arfanbabaucoder/Herox/Images/Screenshot 2026-10-18 102629.png

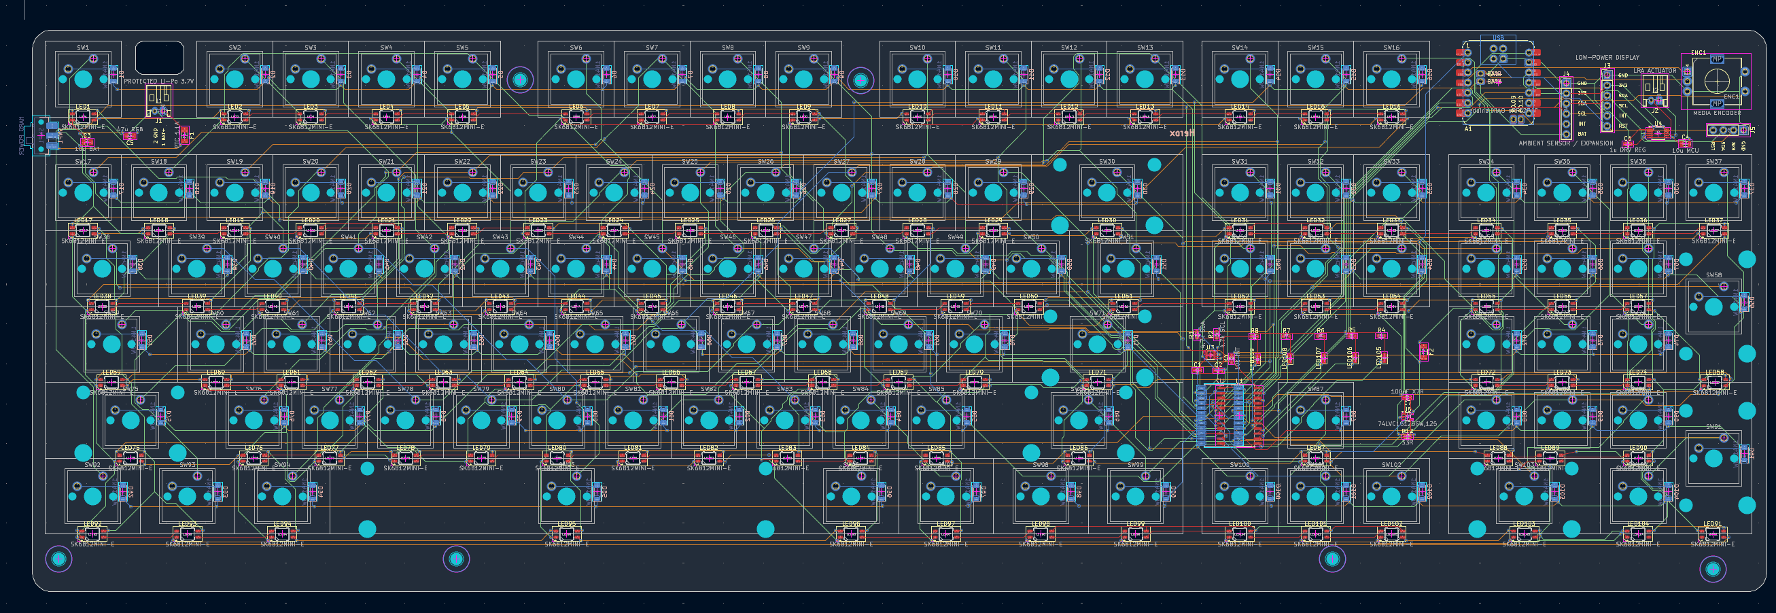
Images/Screenshot 2026-10-18 102629.png
