arfanbabaucoder/Herox/Production/bom.csv

Designator | Footprint | Quantity | Value | LCSC Part #
A1 | Xiao_nRF52840_ACH | 1 | Seeeduino XIAO nRF52840
C1 | 0603 | 1 | 100n U1
C2 | 0603 | 1 | 100n U2
C3 | 0805 | 1 | 10u BAT
C4 | 0805 | 1 | 10u MCU
C5 | 0805 | 1 | 47u RGB
C6 | 0603 | 1 | 1u DRV REG
C7 | 0603 | 1 | 100nF X7R
D1, D10, D100, D101, D102, D103, D104, D11, D12, D13, D14, D15, D16, D17, D18, D19, D2, D20, D21, D22, D23, D24, D25, D26, D27, D28, D29, D3, D30, D31, D32, D33, D34, D35, D36, D37, D38, D39, D4, D40, D41, D42, D43, D44, D45, D46, D47, D48, D49, D5, D50, D51, D52, D53, D54, D55, D56, D57, D58, D59, D6, D60, D61, D62, D63, D64, D65, D66, D67, D68, D69, D7, D70, D71, D72, D73, D74, D75, D76, D77, D78, D79, D8, D80, D81, D82, D83, D84, D85, D86, D87, D88, D89, D9, D90, D91, D92, D93, D94, D95, D96, D97, D98, D99 | D_SOD-123 | 104 | 1N4148W
ENC1 | RotaryEncoder_Alps_EC11E-Switch_Vertical_H20mm | 1 | MEDIA ENCODER
F1 | 1206 | 1 | PTC 1.1A
F2 | 1206 | 1 | PTC 0.5A / USB RGB
J1 | JST_PH_S2B-PH-K_1x02_P2.00mm_Horizontal | 1 | PROTECTED Li-Po 3.7V
J2 | JST_PH_S2B-PH-K_1x02_P2.00mm_Horizontal | 1 | LRA ACTUATOR
J3 | PinHeader_1x06_P2.54mm_Vertical | 1 | LOW-POWER DISPLAY
J4 | PinHeader_1x06_P2.54mm_Vertical | 1 | AMBIENT SENSOR / EXPANSION
J5 | PinHeader_1x04_P2.54mm_Vertical | 1 | SWD DEBUG
LED1, LED10, LED100, LED101, LED102, LED103, LED104, LED11, LED12, LED13, LED14, LED15, LED16, LED17, LED18, LED19, LED2, LED20, LED21, LED22, LED23, LED24, LED25, LED26, LED27, LED28, LED29, LED3, LED30, LED31, LED32, LED33, LED34, LED35, LED36, LED37, LED38, LED39, LED4, LED40, LED41, LED42, LED43, LED44, LED45, LED46, LED47, LED48, LED49, LED5, LED50, LED51, LED52, LED53, LED54, LED55, LED56, LED57, LED58, LED59, LED6, LED60, LED61, LED62, LED63, LED64, LED65, LED66, LED67, LED68, LED69, LED7, LED70, LED71, LED72, LED73, LED74, LED75, LED76, LED77, LED78, LED79, LED8, LED80, LED81, LED82, LED83, LED84, LED85, LED86, LED87, LED88, LED89, LED9, LED90, LED91, LED92, LED93, LED94, LED95, LED96, LED97, LED98, LED99 | LED_SK6812MINI-E_3.2x2.8mm_P1.5mm_ReverseMount | 104 | SK6812MINI-E
LED105, LED106 | 0603 | 2 | XL-1608UGC-04 GREEN
LED107, LED108, LED109 | 0603 | 3 | LTST-C193TBKT-5A BLUE
R1 | 0603 | 1 | 4.7k SDA
R12 | 0603 | 1 | 33R
R2 | 0603 | 1 | 4.7k SCL
R3 | 0603 | 1 | 10k INT
R4, R5, R6, R7, R8 | 0603 | 5 | 1k STATUS
SW1 | SW_MX_1.00u | 1 | Esc
SW10 | SW_MX_1.00u | 1 | F9
SW100 | SW_MX_1.00u | 1 | Left
SW101 | SW_MX_1.00u | 1 | Down
SW102 | SW_MX_1.00u | 1 | Right
SW103 | SW_MX_2.00u | 1 | 0
SW104 | SW_MX_1.00u | 1 | .
SW11 | SW_MX_1.00u | 1 | F10
SW12 | SW_MX_1.00u | 1 | F11
SW13 | SW_MX_1.00u | 1 | F12
SW14 | SW_MX_1.00u | 1 | PrtSc
SW15 | SW_MX_1.00u | 1 | Scroll
SW16 | SW_MX_1.00u | 1 | Pause
SW17 | SW_MX_1.00u | 1 | `~
SW18 | SW_MX_1.00u | 1 | 1!
SW19 | SW_MX_1.00u | 1 | 2@
SW2 | SW_MX_1.00u | 1 | F1
SW20 | SW_MX_1.00u | 1 | 3#
SW21 | SW_MX_1.00u | 1 | 4$
SW22 | SW_MX_1.00u | 1 | 5%
SW23 | SW_MX_1.00u | 1 | 6^
SW24 | SW_MX_1.00u | 1 | 7&
SW25 | SW_MX_1.00u | 1 | 8*
SW26 | SW_MX_1.00u | 1 | 9(
SW27 | SW_MX_1.00u | 1 | 0)
SW28 | SW_MX_1.00u | 1 | -_
SW29 | SW_MX_1.00u | 1 | =+
SW3 | SW_MX_1.00u | 1 | F2
SW30 | SW_MX_2.00u | 1 | Backspace
SW31 | SW_MX_1.00u | 1 | Insert
SW32 | SW_MX_1.00u | 1 | Home
SW33 | SW_MX_1.00u | 1 | PgUp
SW34 | SW_MX_1.00u | 1 | Num
SW35 | SW_MX_1.00u | 1 | /
SW36 | SW_MX_1.00u | 1 | *
SW37 | SW_MX_1.00u | 1 | -
SW38 | SW_MX_1.50u | 1 | Tab
SW39 | SW_MX_1.00u | 1 | Q
SW4 | SW_MX_1.00u | 1 | F3
SW40 | SW_MX_1.00u | 1 | W
SW41 | SW_MX_1.00u | 1 | E
SW42 | SW_MX_1.00u | 1 | R
SW43 | SW_MX_1.00u | 1 | T
SW44 | SW_MX_1.00u | 1 | Y
SW45 | SW_MX_1.00u | 1 | U
SW46 | SW_MX_1.00u | 1 | I
SW47 | SW_MX_1.00u | 1 | O
SW48 | SW_MX_1.00u | 1 | P
SW49 | SW_MX_1.00u | 1 | [{
SW5 | SW_MX_1.00u | 1 | F4
SW50 | SW_MX_1.00u | 1 | ]}
SW51 | SW_MX_1.50u | 1 | \
SW52 | SW_MX_1.00u | 1 | Delete
SW53 | SW_MX_1.00u | 1 | End
SW54 | SW_MX_1.00u | 1 | PgDn
SW55 | SW_MX_1.00u | 1 | 7
SW56 | SW_MX_1.00u | 1 | 8
SW57 | SW_MX_1.00u | 1 | 9
SW58 | SW_MX_2.00u_Vertical | 1 | +
SW59 | SW_MX_1.75u | 1 | Caps
SW6 | SW_MX_1.00u | 1 | F5
SW60 | SW_MX_1.00u | 1 | A
SW61 | SW_MX_1.00u | 1 | S
SW62 | SW_MX_1.00u | 1 | D
SW63 | SW_MX_1.00u | 1 | F
SW64 | SW_MX_1.00u | 1 | G
SW65 | SW_MX_1.00u | 1 | H
SW66 | SW_MX_1.00u | 1 | J
SW67 | SW_MX_1.00u | 1 | K
SW68 | SW_MX_1.00u | 1 | L
SW69 | SW_MX_1.00u | 1 | ;:
SW7 | SW_MX_1.00u | 1 | F6
SW70 | SW_MX_1.00u | 1 | '"
SW71 | SW_MX_2.25u | 1 | Enter
SW72 | SW_MX_1.00u | 1 | 4
SW73 | SW_MX_1.00u | 1 | 5
SW74 | SW_MX_1.00u | 1 | 6
SW75 | SW_MX_2.25u | 1 | LShift
SW76 | SW_MX_1.00u | 1 | Z
SW77 | SW_MX_1.00u | 1 | X
SW78 | SW_MX_1.00u | 1 | C
SW79 | SW_MX_1.00u | 1 | V
SW8 | SW_MX_1.00u | 1 | F7
SW80 | SW_MX_1.00u | 1 | B
SW81 | SW_MX_1.00u | 1 | N
SW82 | SW_MX_1.00u | 1 | M
SW83 | SW_MX_1.00u | 1 | ,<
SW84 | SW_MX_1.00u | 1 | .>
SW85 | SW_MX_1.00u | 1 | /?
SW86 | SW_MX_2.75u | 1 | RShift
SW87 | SW_MX_1.00u | 1 | Up
SW88 | SW_MX_1.00u | 1 | 1
SW89 | SW_MX_1.00u | 1 | 2
SW9 | SW_MX_1.00u | 1 | F8
SW90 | SW_MX_1.00u | 1 | 3
SW91 | SW_MX_2.00u_Vertical | 1 | NEnter
SW92 | SW_MX_1.25u | 1 | LCtrl
SW93 | SW_MX_1.25u | 1 | LWin
SW94 | SW_MX_1.25u | 1 | LAlt
SW95 | SW_MX_6.25u | 1 | Space
SW96 | SW_MX_1.25u | 1 | RAlt
SW97 | SW_MX_1.25u | 1 | RWin
SW98 | SW_MX_1.25u | 1 | Menu
SW99 | SW_MX_1.25u | 1 | RCtrl
SWP1 | SW_SPDT_CK_JS102011SAQN | 1 | HARD POWER
U1 | SOIC-24W_7.5x15.4mm_P1.27mm | 1 | TCA9555DW / ROW DRIVE
U2 | SOIC-24W_7.5x15.4mm_P1.27mm | 1 | TCA9555DW / COLUMN SENSE
U3 | TDFN-8-1EP_2x2mm_P0.5mm_EP0.8x1.2mm | 1 | MAX17048G+T10 FUEL GAUGE
U4 | MSOP-10_3x3mm_P0.5mm | 1 | DRV2605L HAPTIC DRIVER
U5 | SOT-353_SC-70-5 | 1 | 74LVC1G125GW,125
