arfanbabaucoder/Herox/BOM Images/Screenshoot 2026-10-18 210038.jpeg

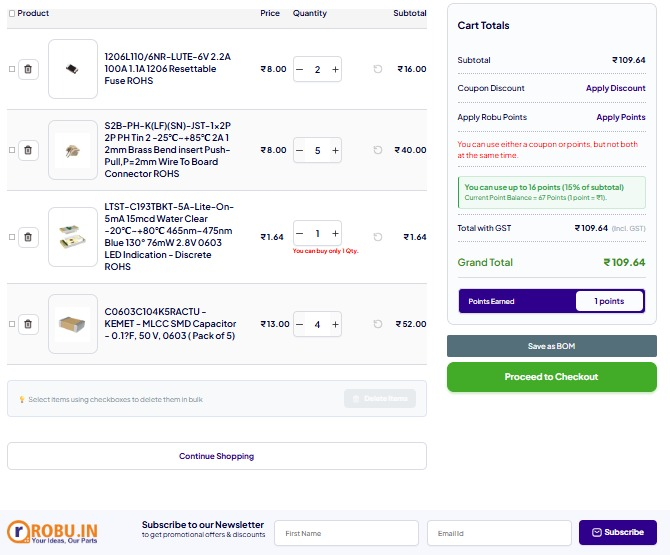
BOM Images/Screenshoot 2026-10-18 210038.jpeg
