arfanbabaucoder/Herox/BOM Images/Screenshot 2026-10-18 202717.png

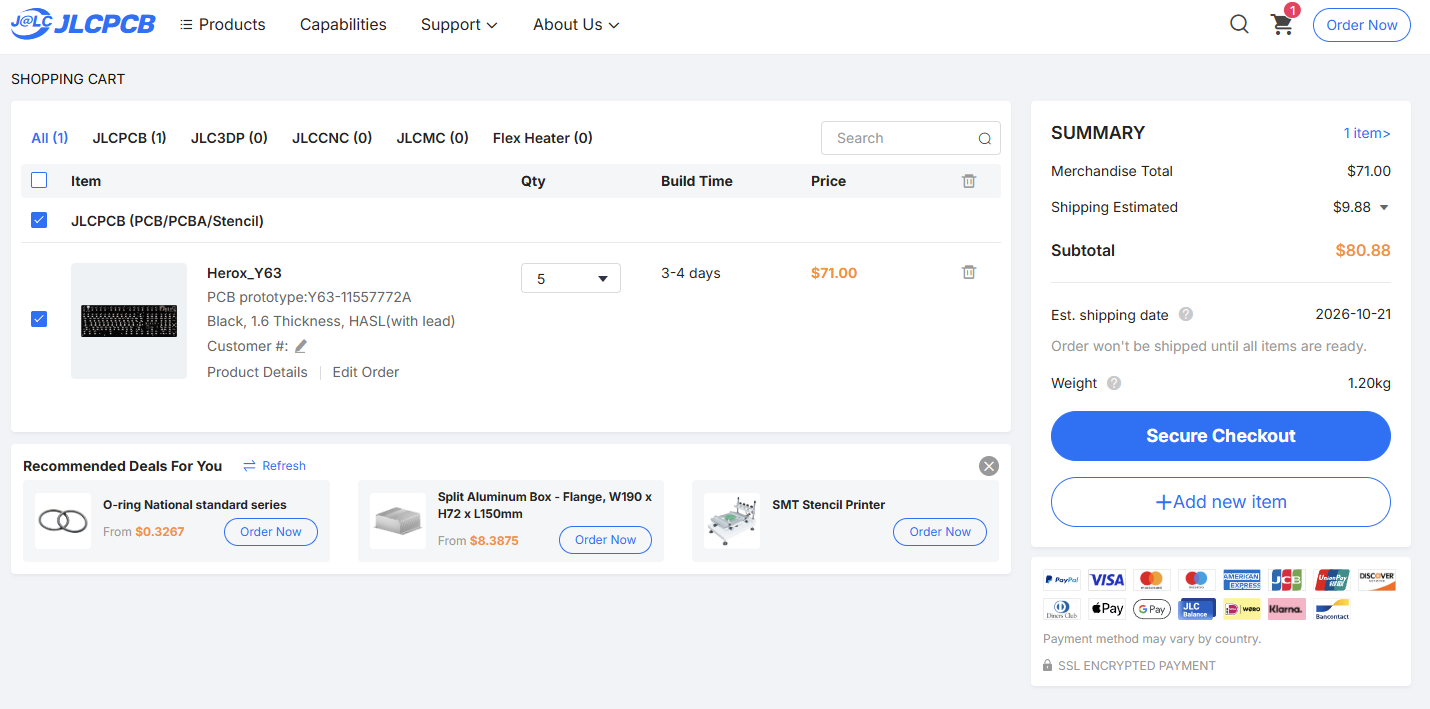
BOM Images/Screenshot 2026-10-18 202717.png
