arfanbabaucoder/Herox/BOM Images/Screenshot 2026-10-18 202721.png

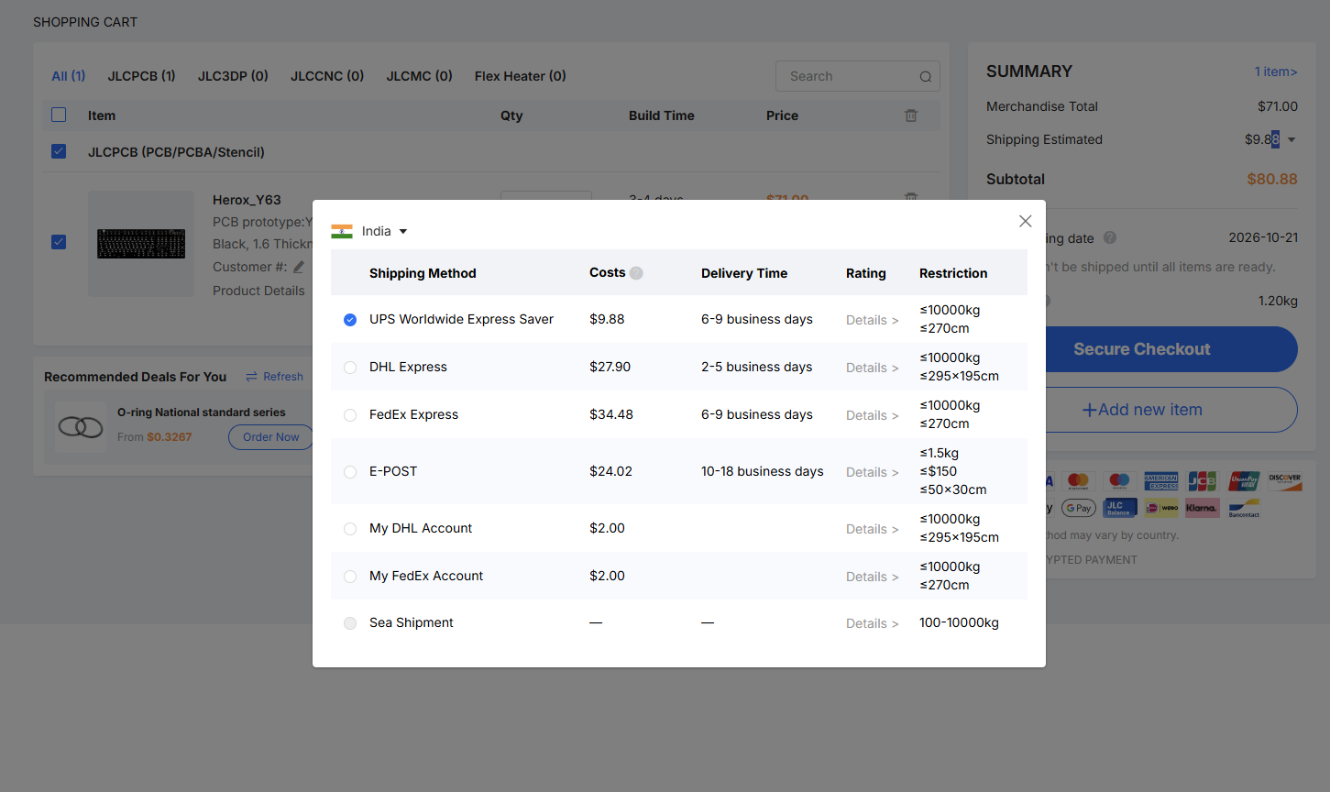
BOM Images/Screenshot 2026-10-18 202721.png
