arfanbabaucoder/Herox/BOM Images/Screenshot 2026-10-18 210037.png

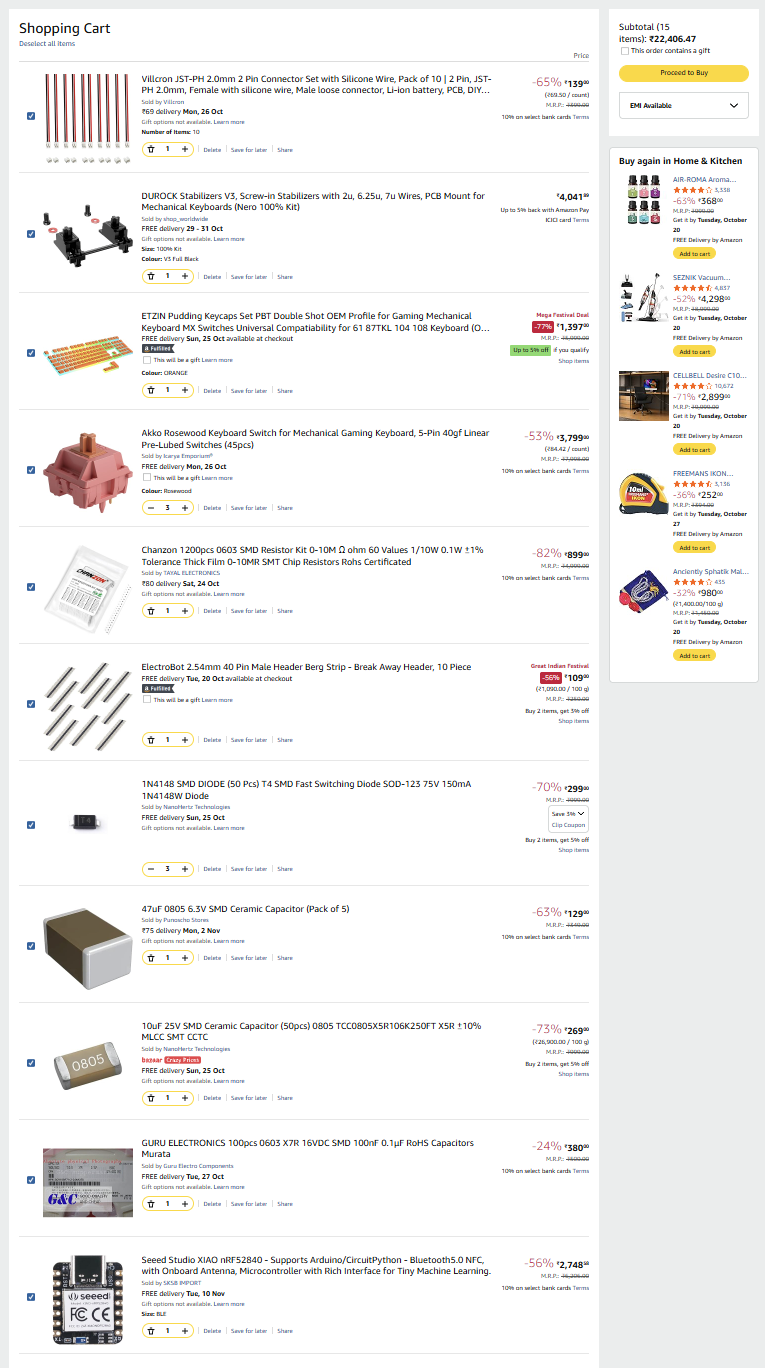
BOM Images/Screenshot 2026-10-18 210037.png
