arfanbabaucoder/Herox/3D CAD/Full/Herox.step

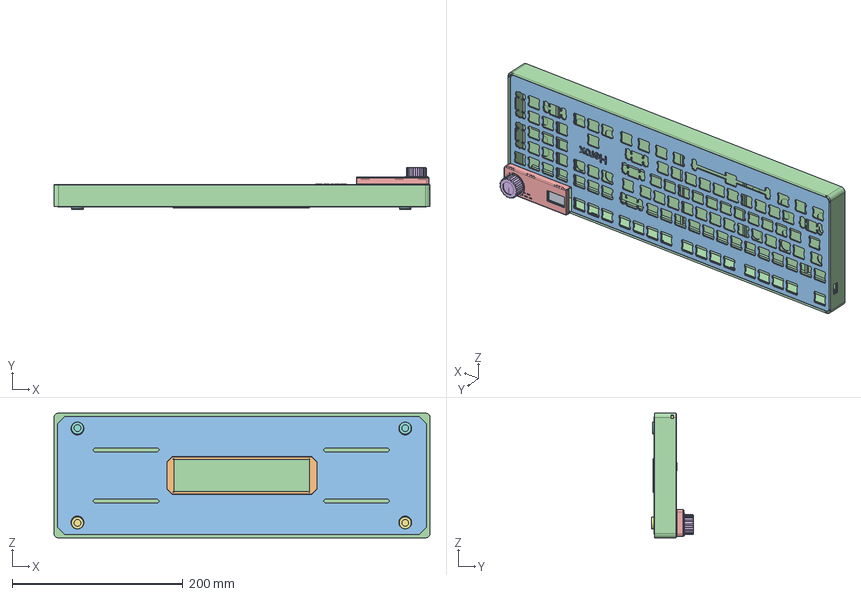
[picture p25: CAD file, 2026-10-18]
3D CAD/Full/Herox.step
440.5 x 48.9 x 146.0 mm
