arfanbabaucoder/Herox/3D CAD/Printables/Front_Right_Foot.stl

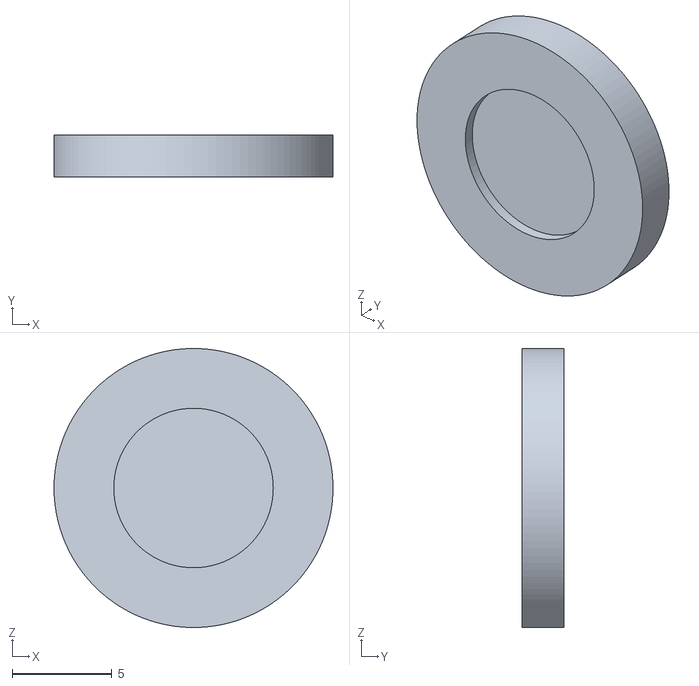
[picture p26: CAD file, 2026-10-18]
3D CAD/Printables/Front_Right_Foot.stl
14.0 x 2.10 x 14.0
