arfanbabaucoder/Herox/3D CAD/Printables/Plate_1.6mm.stl

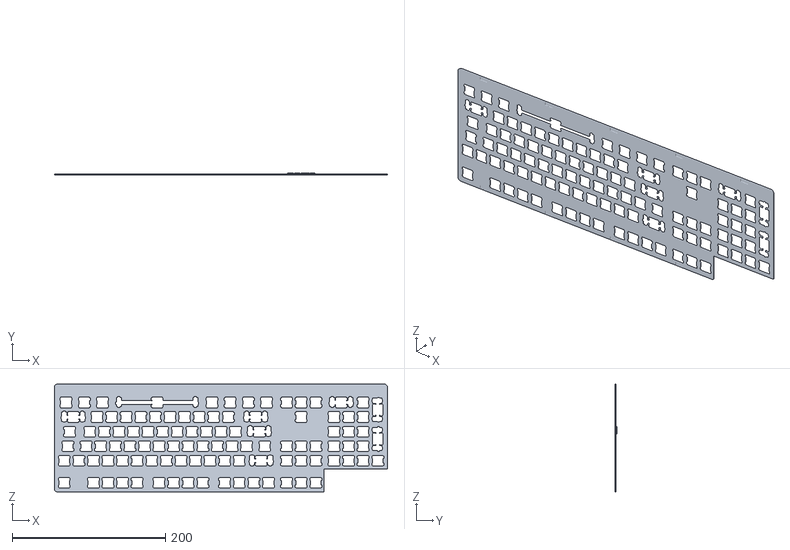
[picture p27: CAD file, 2026-10-18]
3D CAD/Printables/Plate_1.6mm.stl
435.0 x 2.60 x 141.0
