arfanbabaucoder/Herox/PCB/Plate.dxf

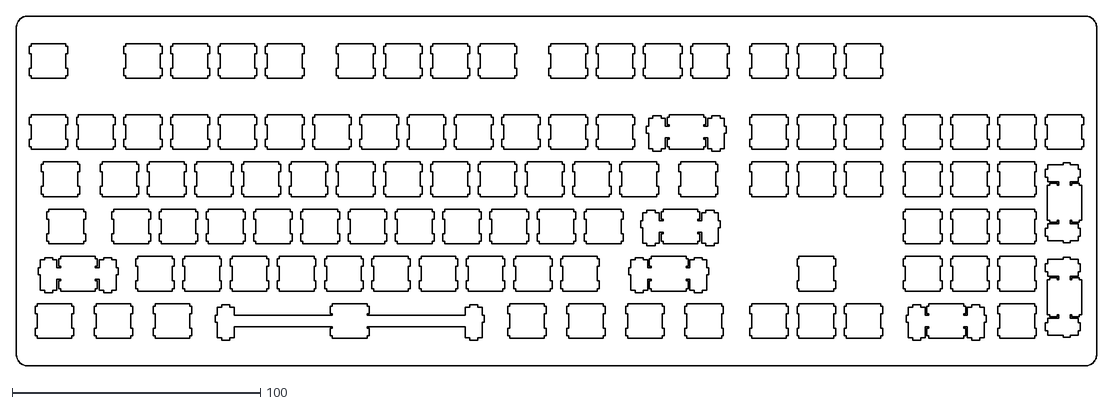
[picture p28: CAD file, 2026-10-18]
PCB/Plate.dxf
435.5 x 141.0
