arfanbabaucoder/Herox/3D CAD/Printables/Rear_Right_Foot.stl

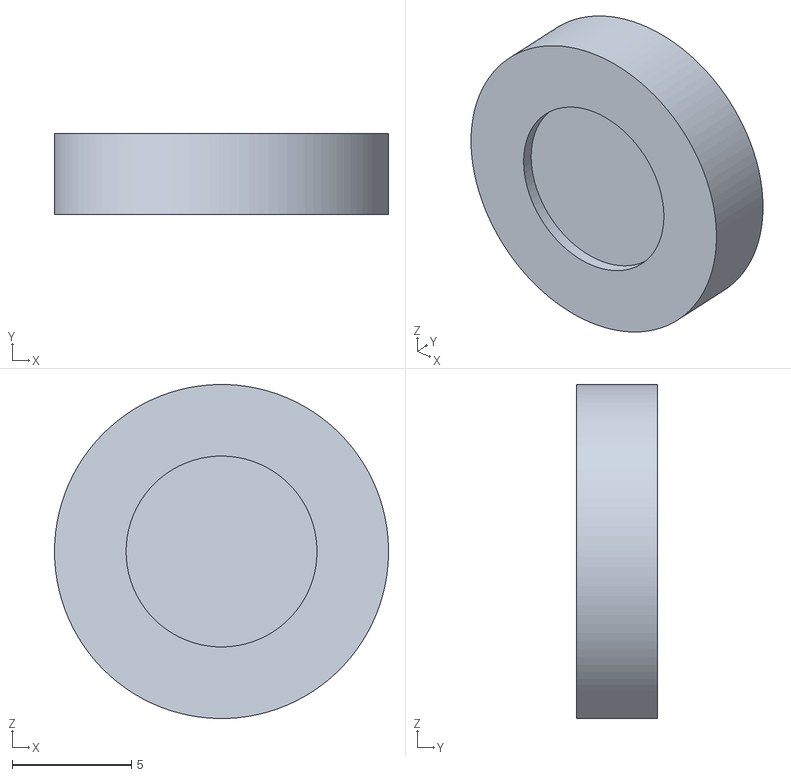
[picture p29: CAD file, 2026-10-18]
3D CAD/Printables/Rear_Right_Foot.stl
14.0 x 3.40 x 14.0
