arfanbabaucoder/Herox/3D CAD/Printables/Integrated_Control_Console.stl

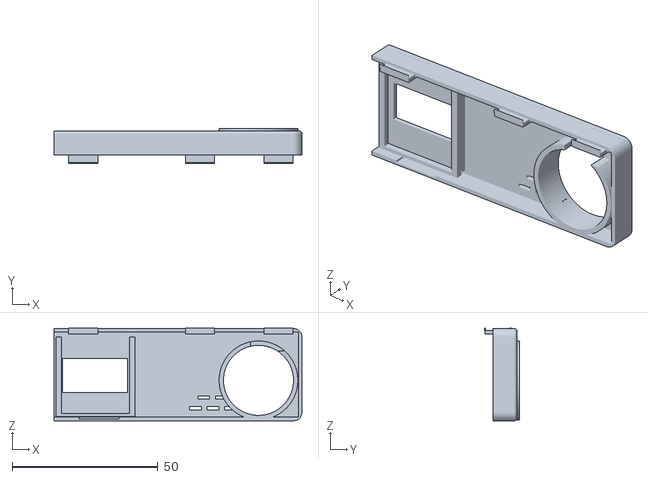
[picture p30: CAD file, 2026-10-18]
3D CAD/Printables/Integrated_Control_Console.stl
85.0 x 11.9 x 31.8
