arfanbabaucoder/Herox/3D CAD/Printables/Encoder_Knob_Cap.stl

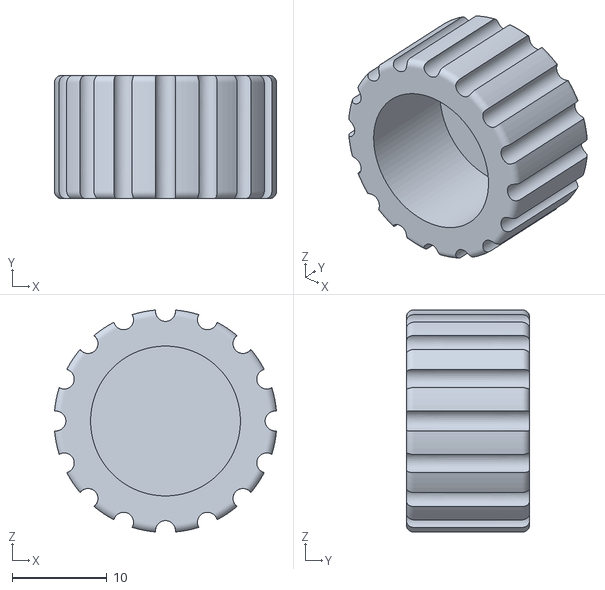
[picture p31: CAD file, 2026-10-18]
3D CAD/Printables/Encoder_Knob_Cap.stl
23.4 x 13.0 x 23.4
