arfanbabaucoder/Herox/3D CAD/Printables/BUTTON + INPUT RACK.stl

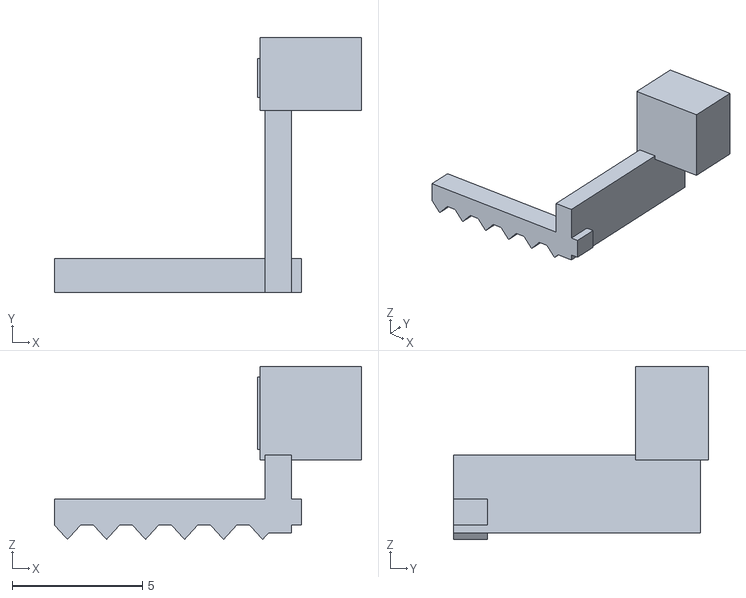
[picture p32: CAD file, 2026-10-18]
3D CAD/Printables/BUTTON + INPUT RACK.stl
11.8 x 9.80 x 6.65
