arfanbabaucoder/Herox/3D CAD/Printables/Bottom_Case_FDM_Print.stl

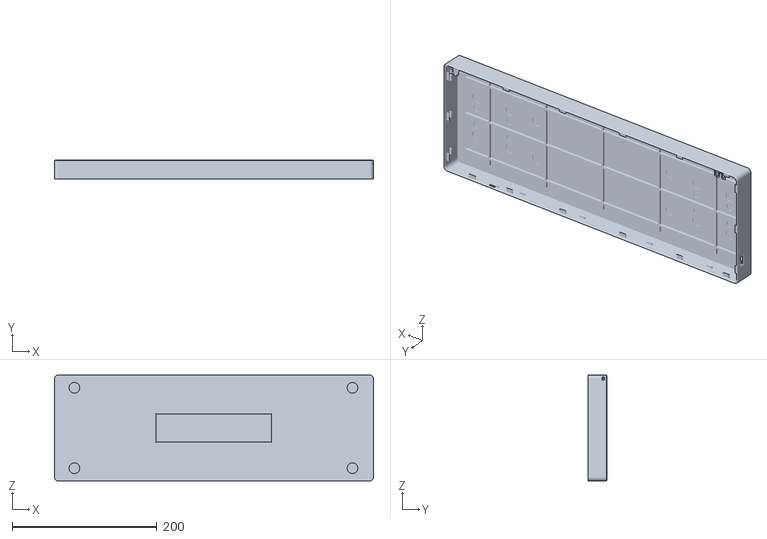
[picture p33: CAD file, 2026-10-18]
3D CAD/Printables/Bottom_Case_FDM_Print.stl
440.5 x 26.0 x 146.0
