arfanbabaucoder/Herox/3D CAD/Printables/Ballast_Press_Release_Key.stl

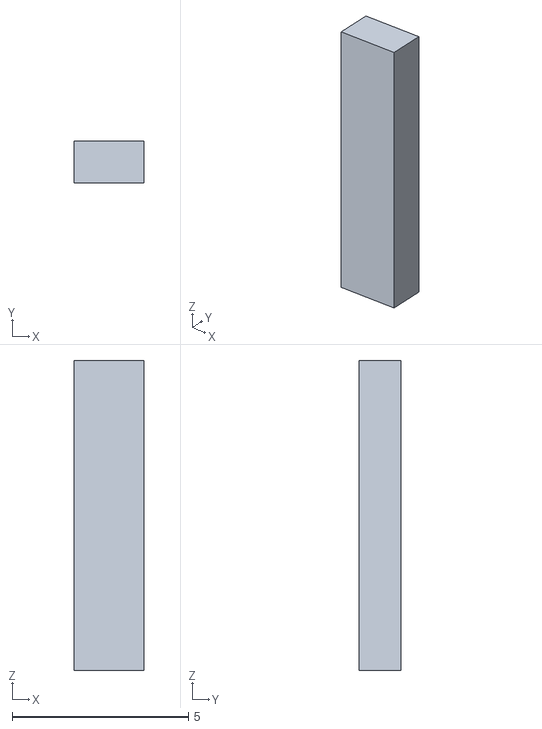
[picture p34: CAD file, 2026-10-18]
3D CAD/Printables/Ballast_Press_Release_Key.stl
2.00 x 1.20 x 8.80
