arfanbabaucoder/Herox/3D CAD/Printables/CARRIAGE - HIDDEN LATCH SLIDER.stl

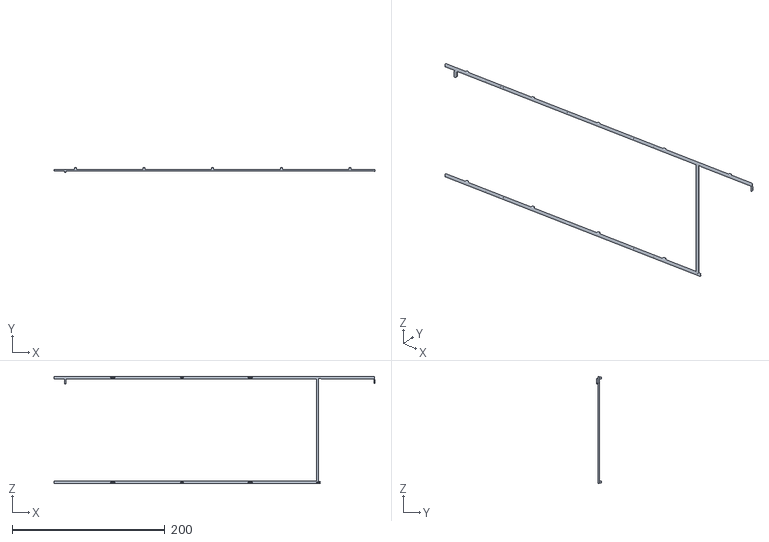
[picture p35: CAD file, 2026-10-18]
3D CAD/Printables/CARRIAGE - HIDDEN LATCH SLIDER.stl
420.8 x 6.05 x 140.4
