arfanbabaucoder/Herox/3D CAD/Printables/Gear.stl

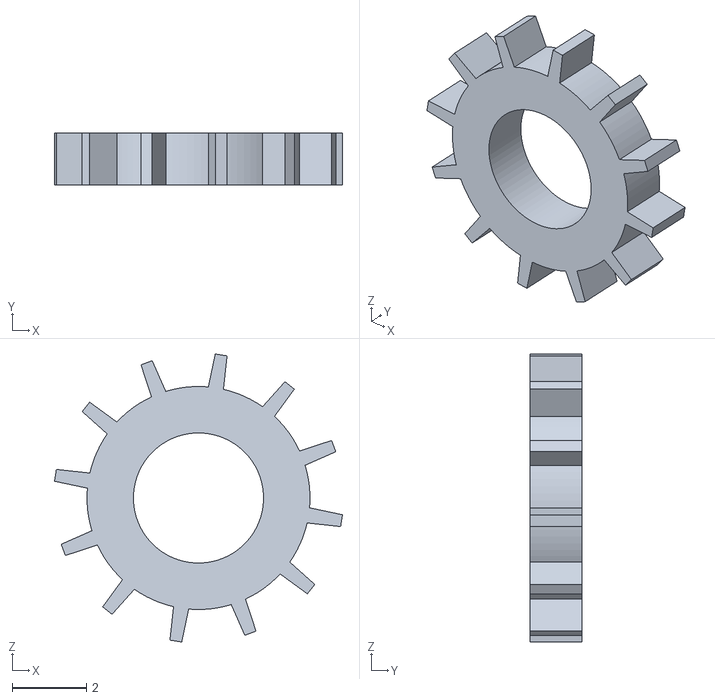
[picture p36: CAD file, 2026-10-18]
3D CAD/Printables/Gear.stl
7.75 x 1.40 x 7.75
