arfanbabaucoder/Herox/3D CAD/Printables/OUTPUT RACK SLIDER.stl

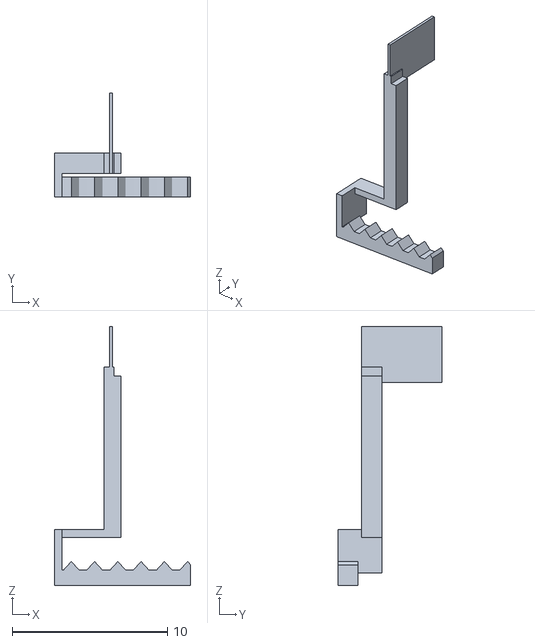
[picture p37: CAD file, 2026-10-18]
3D CAD/Printables/OUTPUT RACK SLIDER.stl
8.80 x 6.70 x 16.7
