arfanbabaucoder/Herox/3D CAD/Printables/Brass_Ballast_158x38x1.stl

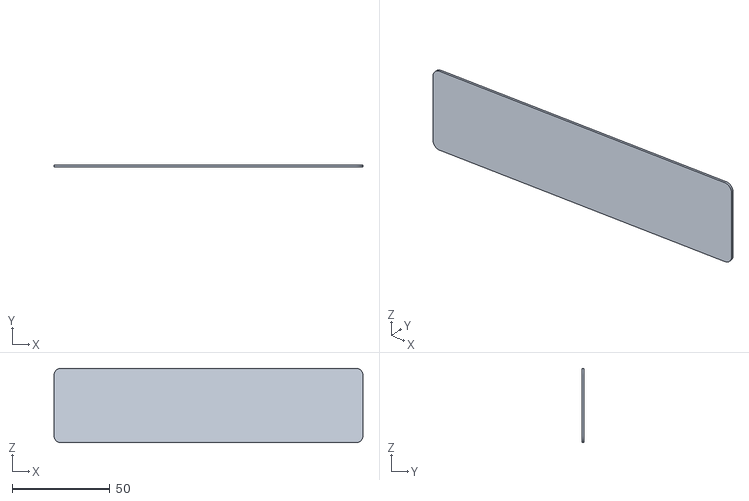
[picture p38: CAD file, 2026-10-18]
3D CAD/Printables/Brass_Ballast_158x38x1.stl
158.0 x 1.00 x 38.0
