arfanbabaucoder/Herox/PCB/JS102011SAQN.STEP

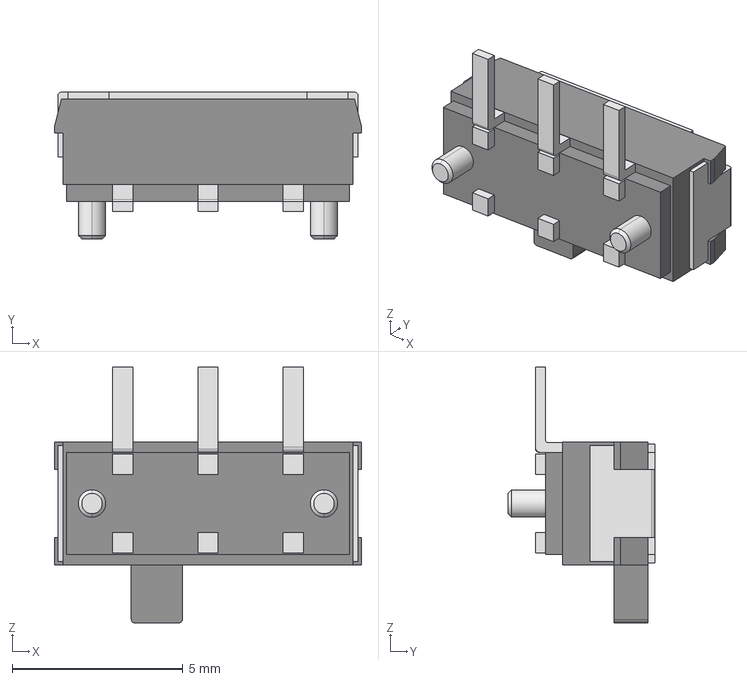
[picture p39: CAD file, 2026-10-18]
PCB/JS102011SAQN.STEP
9.00 x 4.30 x 7.50 mm
