arfanbabaucoder/Herox/(list of files, cad)

Other CAD files:
3D CAD/Printables/Rear_Left_Foot.stl
3D CAD/Printables/Front_Left_Foot.stl
