arfanbabaucoder/Herox/PDFs/Herox Schematic.pdf

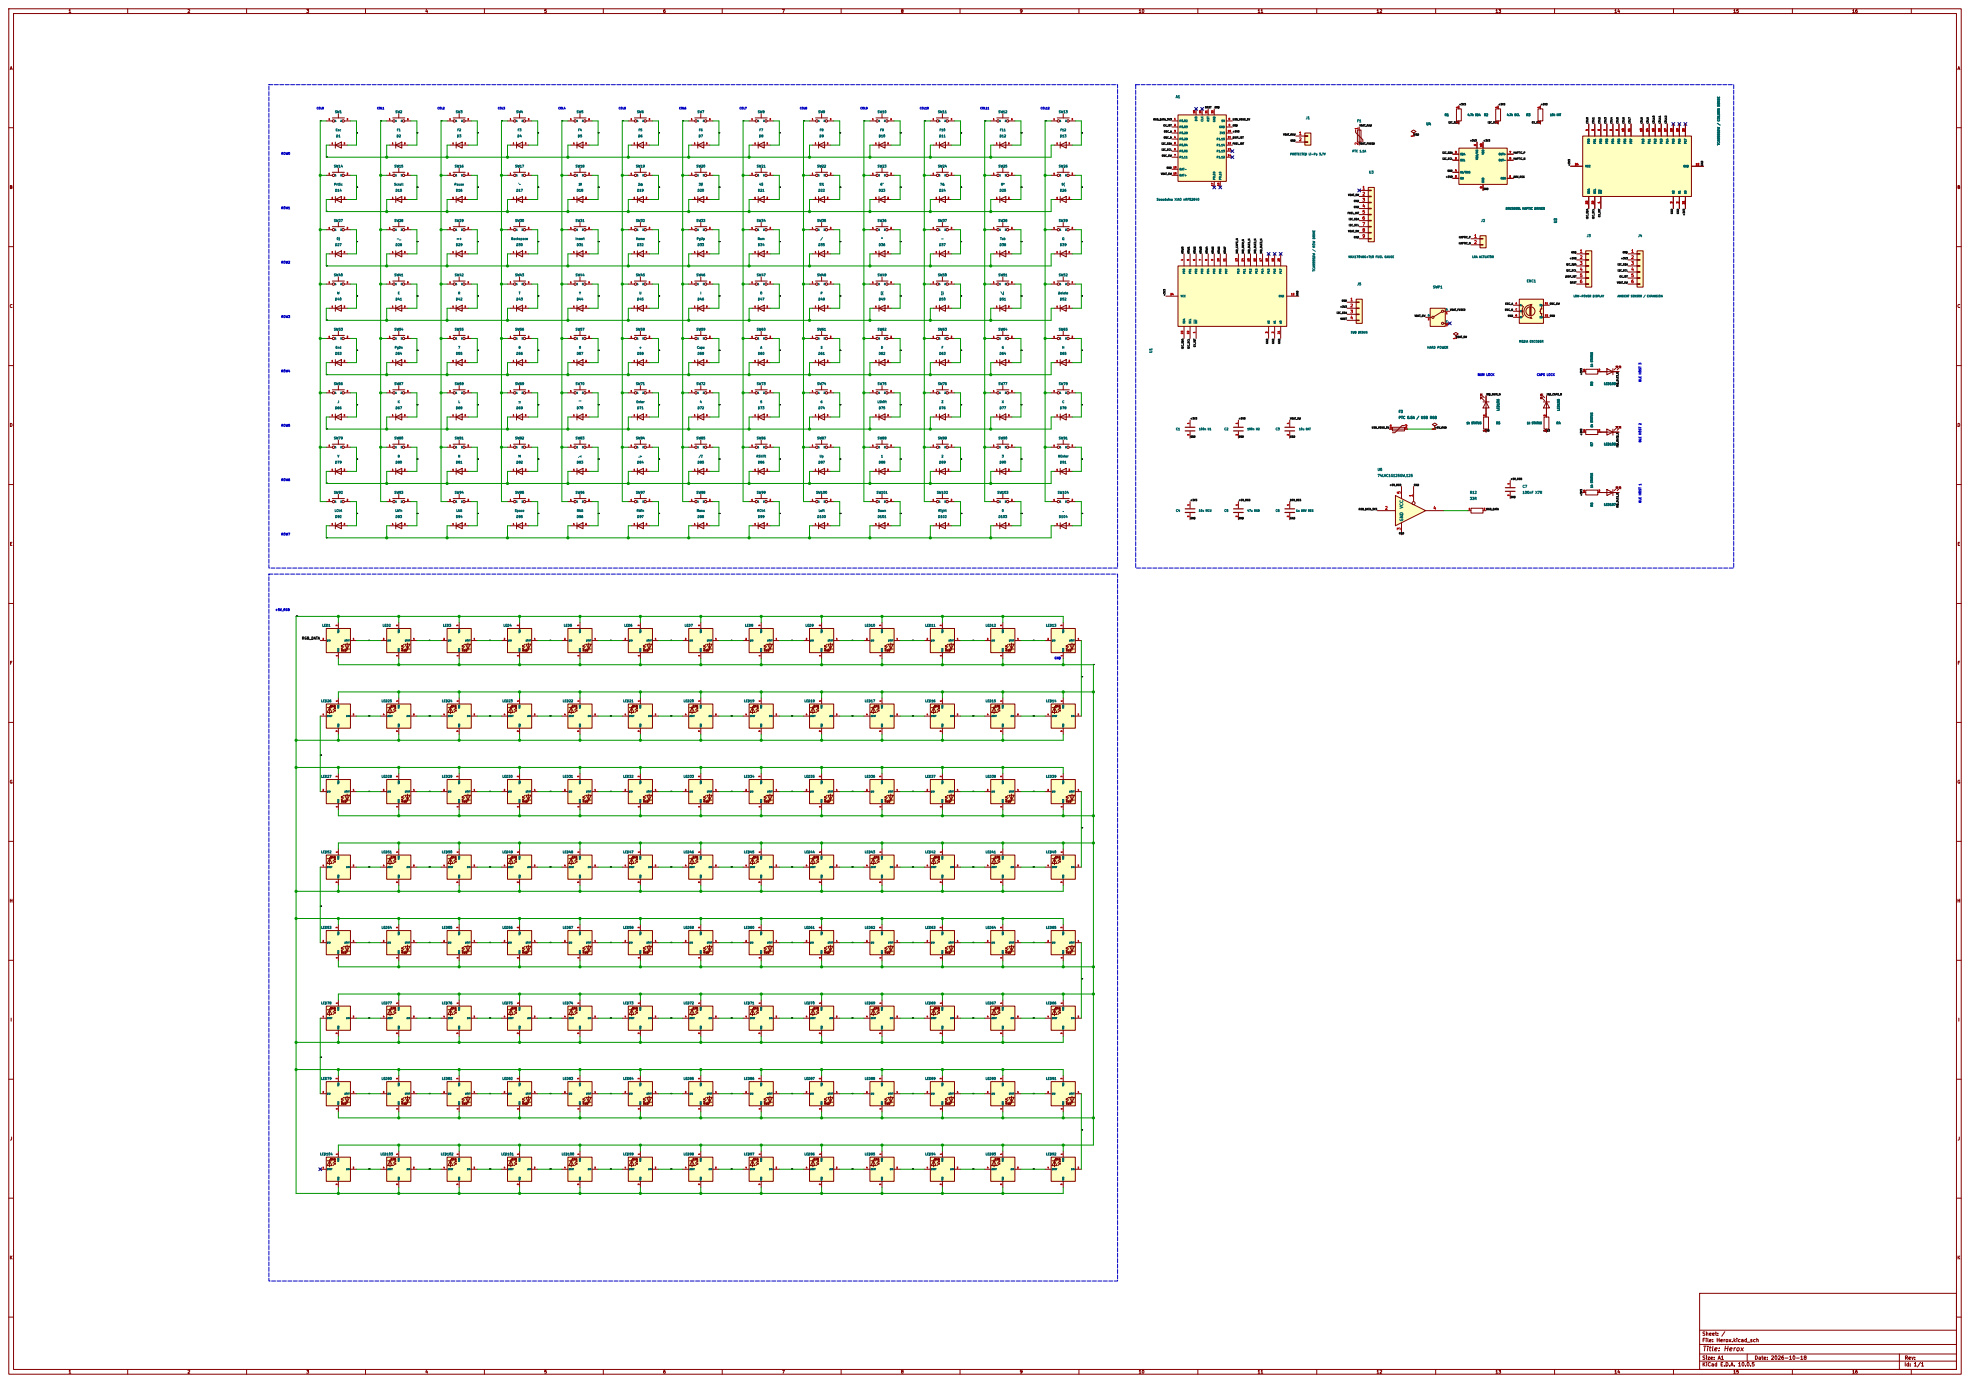
[picture p40: page 1]

Size: A1 | Rev:
KiCad E.D.A. 10.0.5 | Id: 1/1
