arfanbabaucoder/Herox/PDFs/Herox Layout.pdf

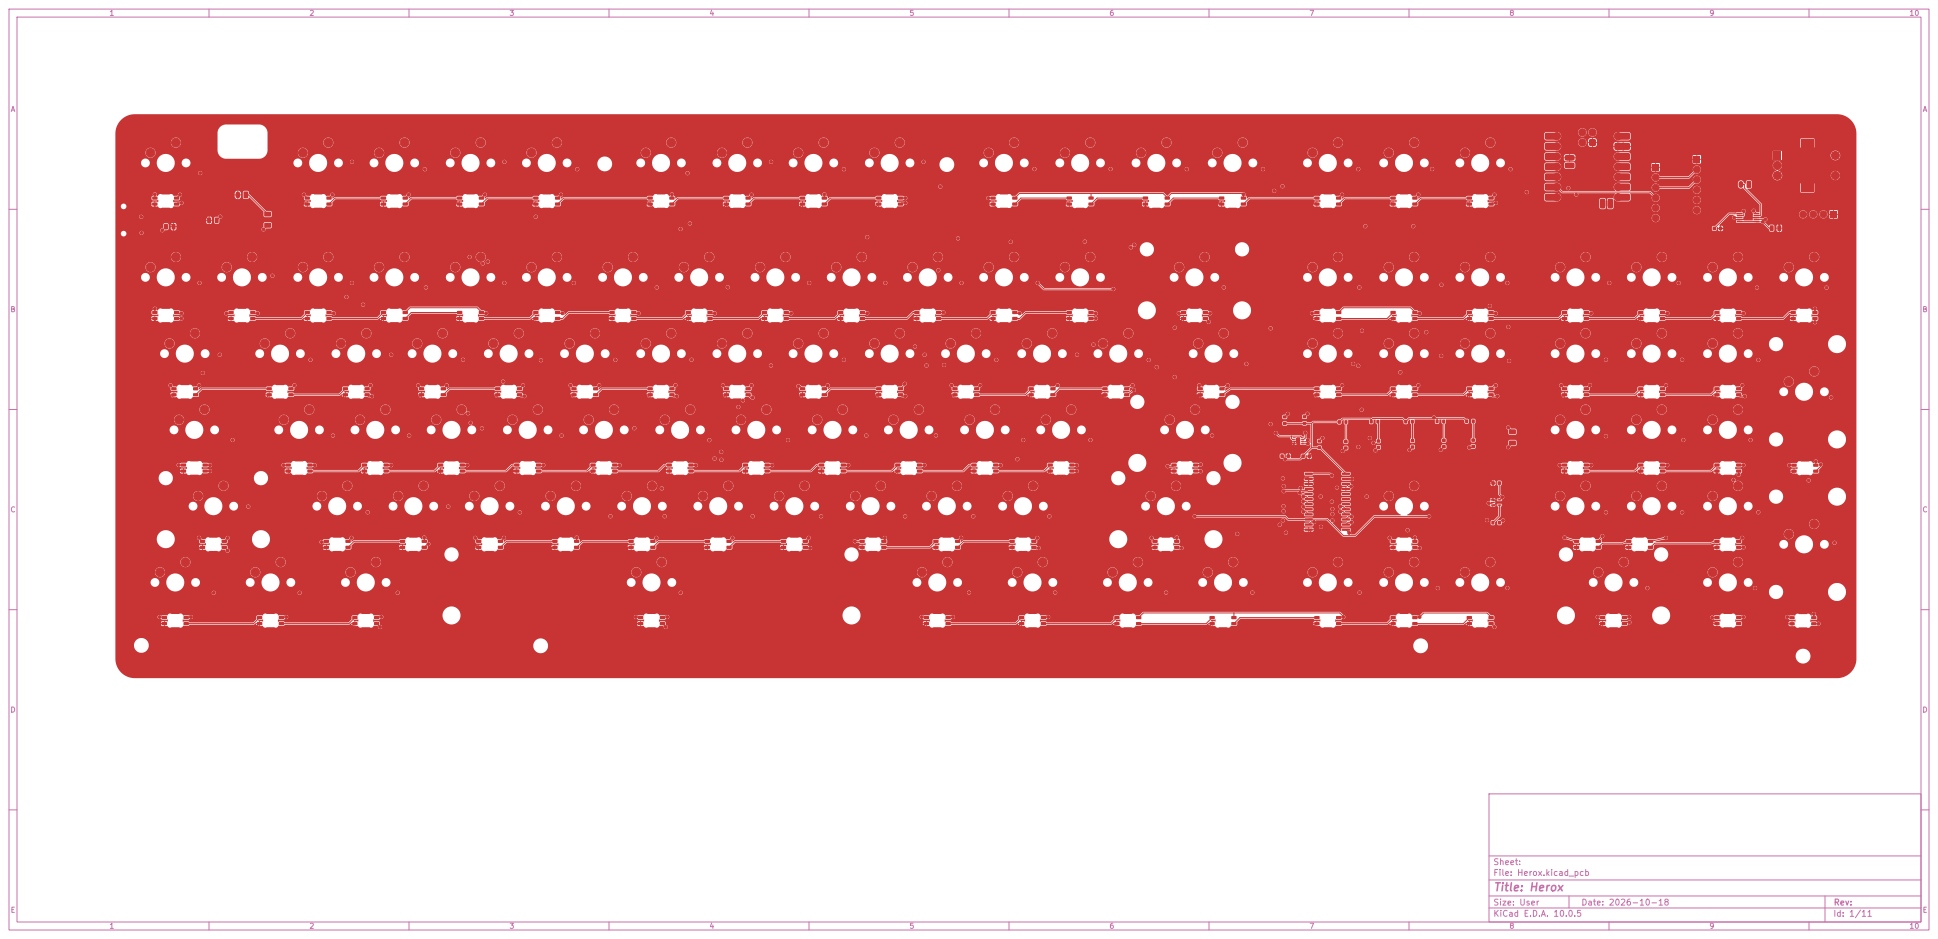
[picture p41: page 1]

Size: User | Rev: | E Date: 2026-10-18
KiCad E.D.A. 10.0.5 | Id: 1/11

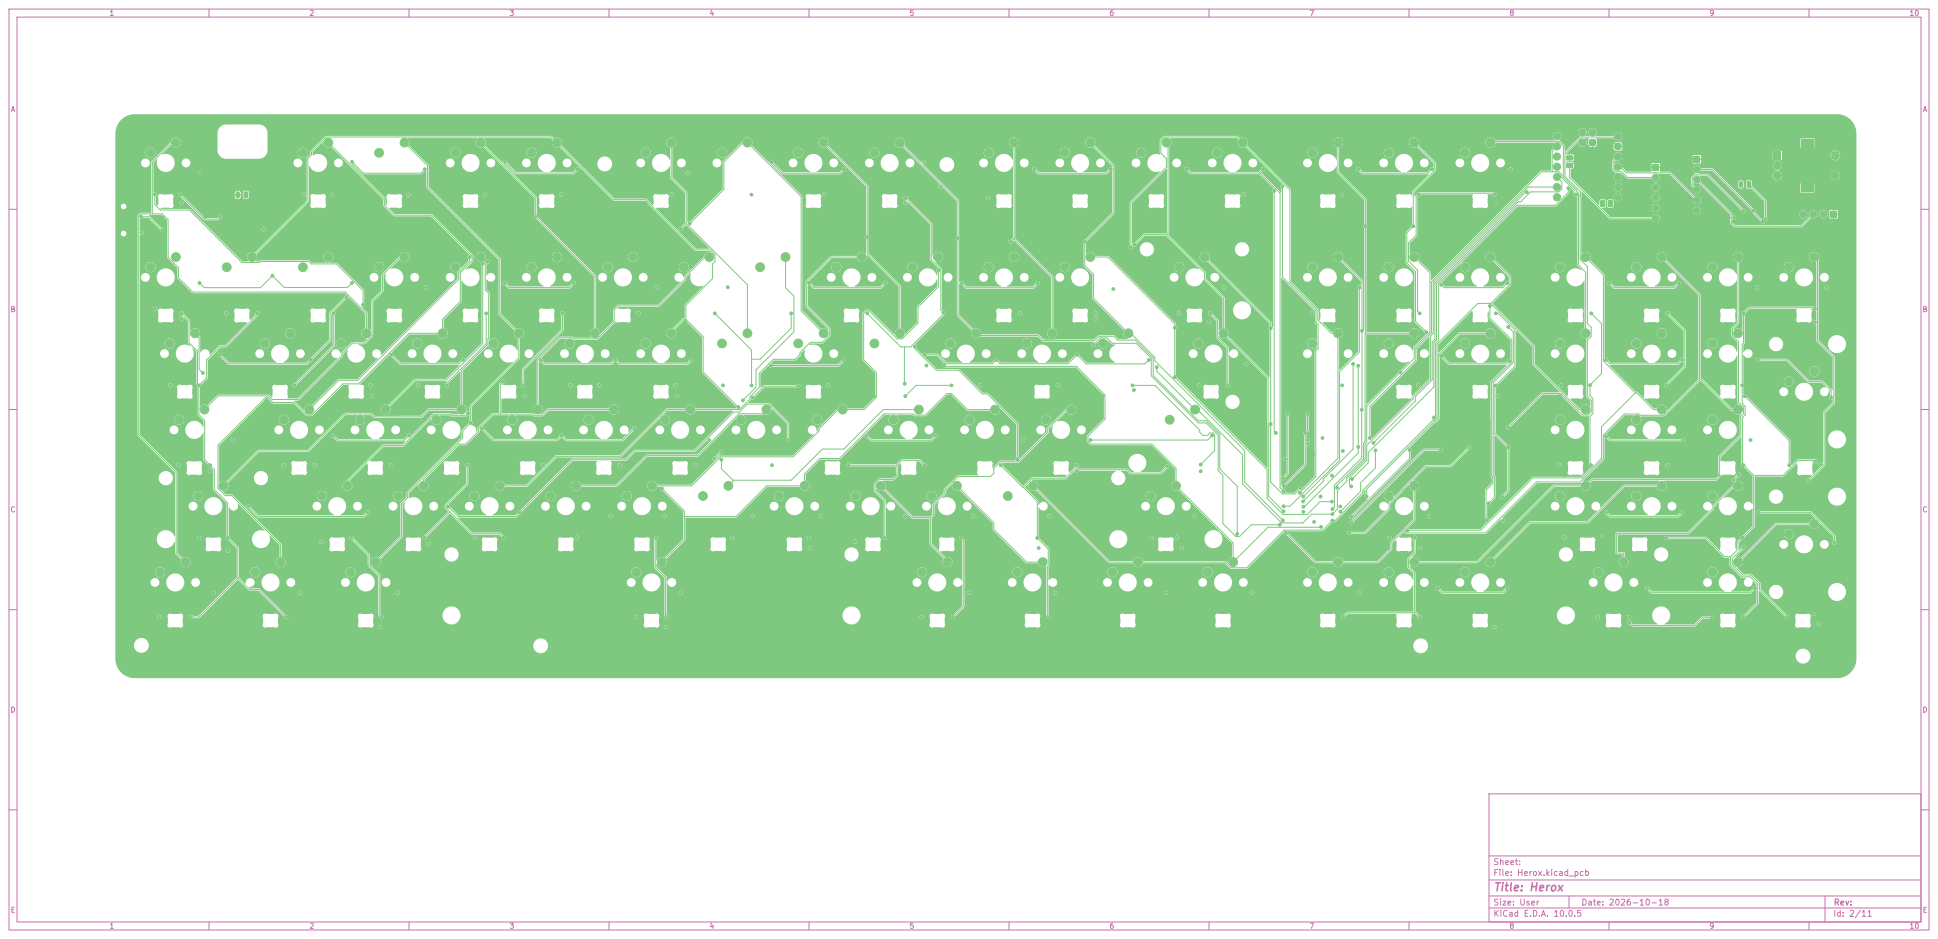
[picture p42: page 2]

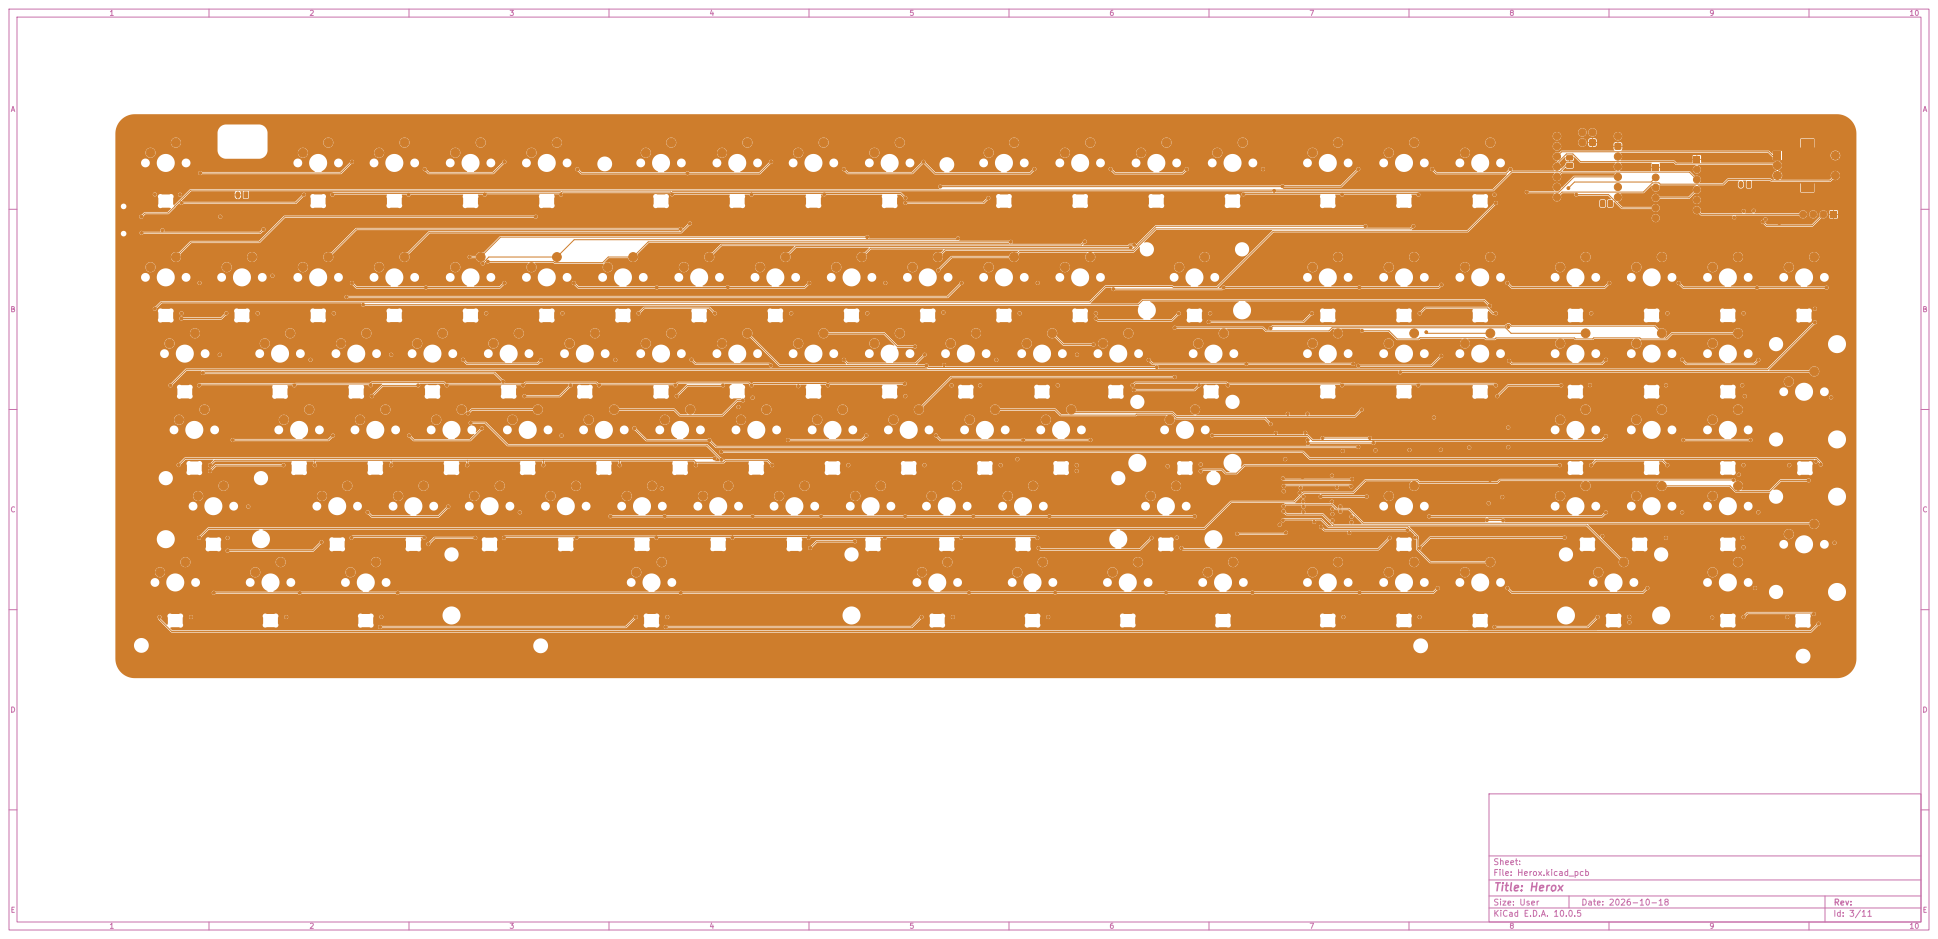
[picture p43: page 3]

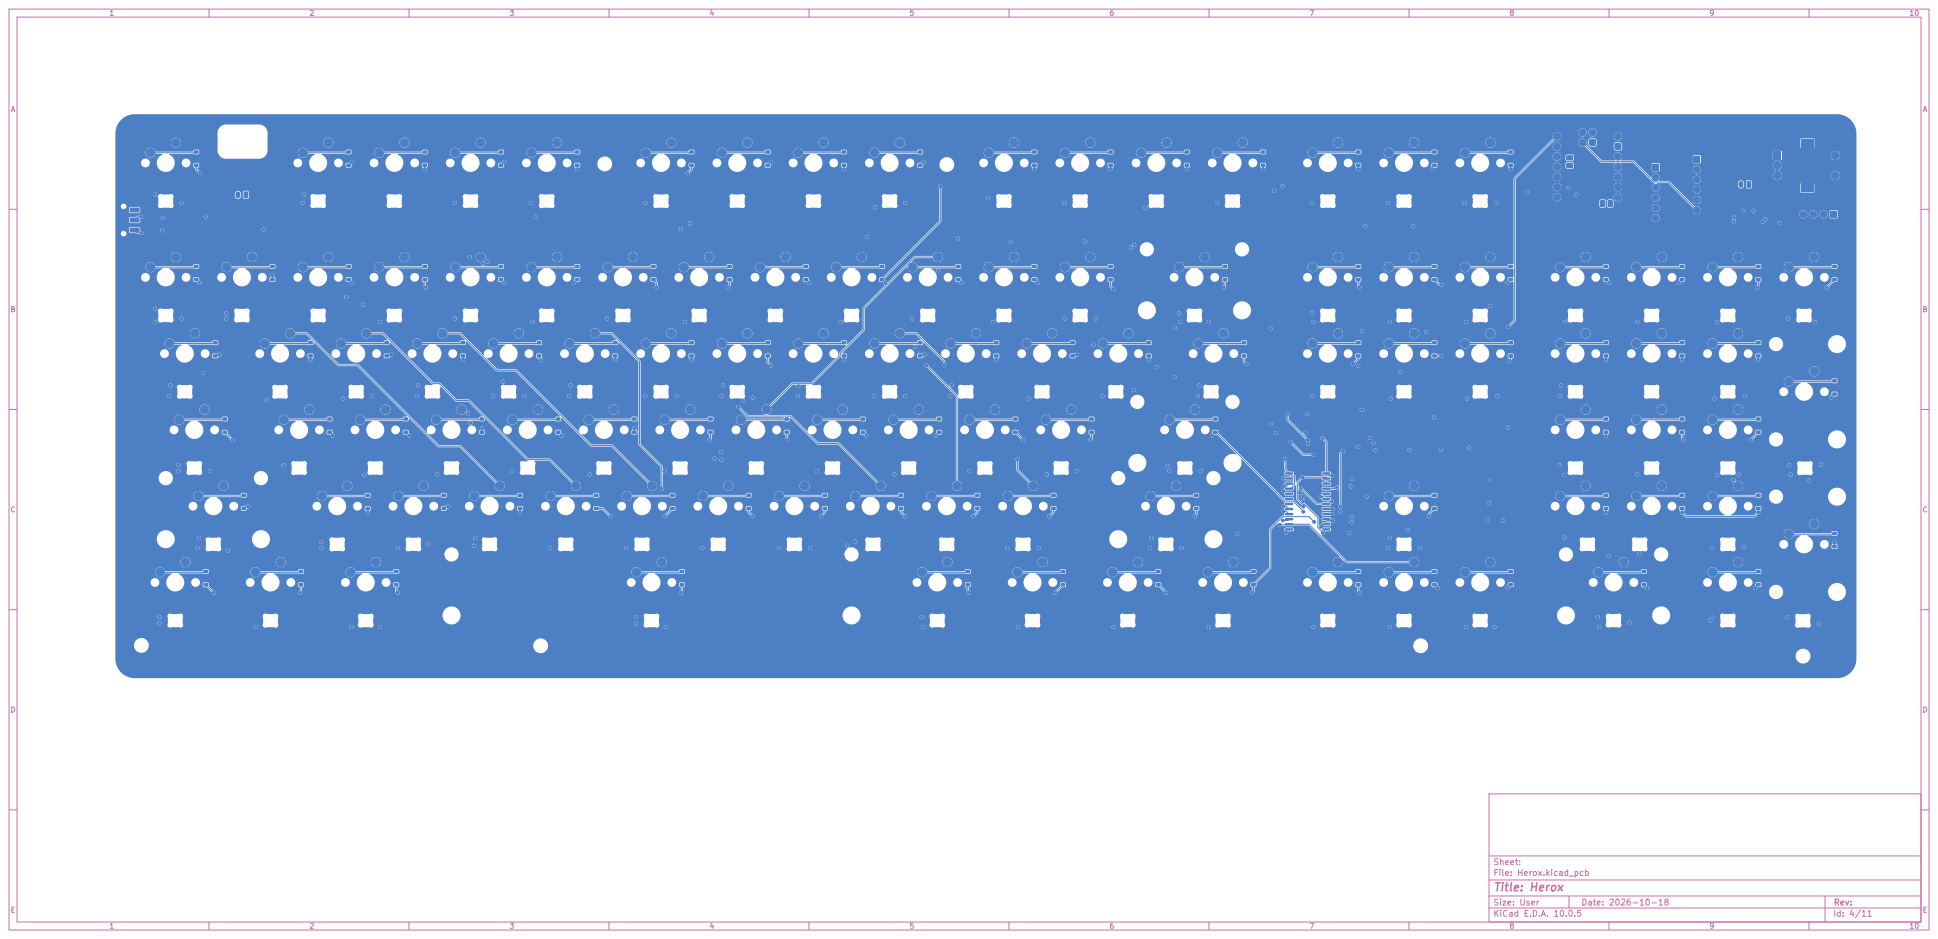
[picture p44: page 4]

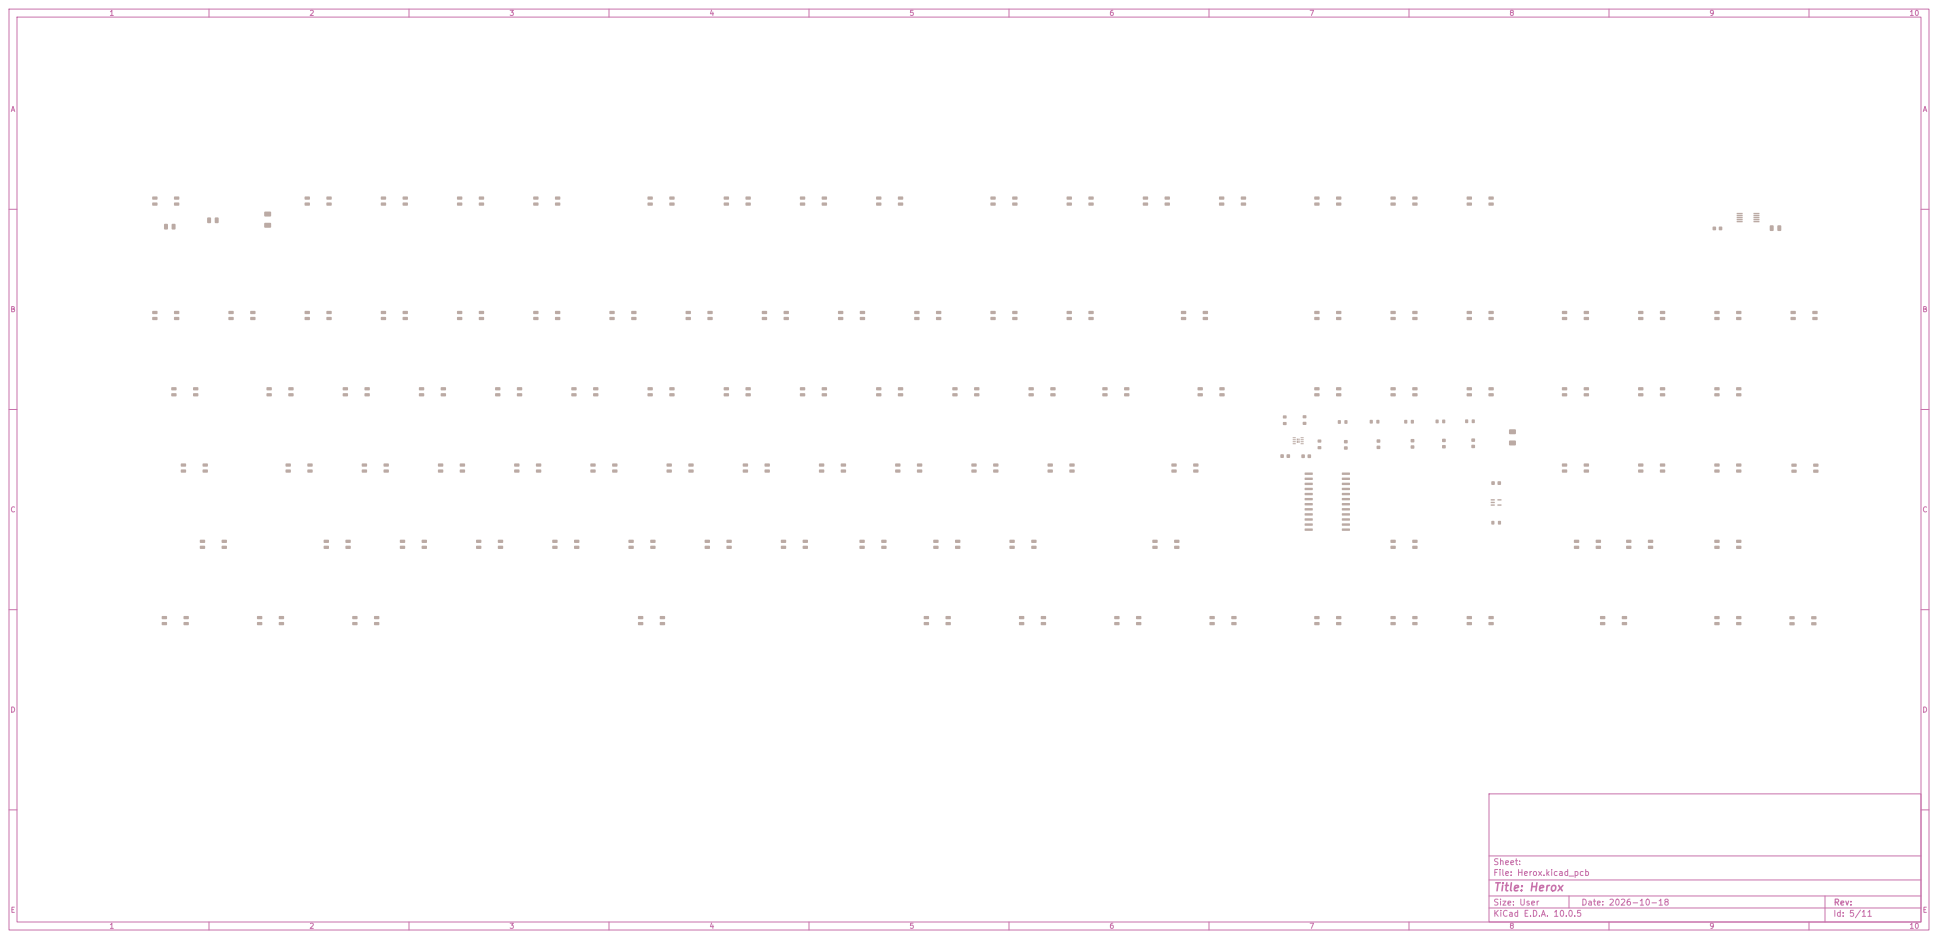
[picture p45: page 5]

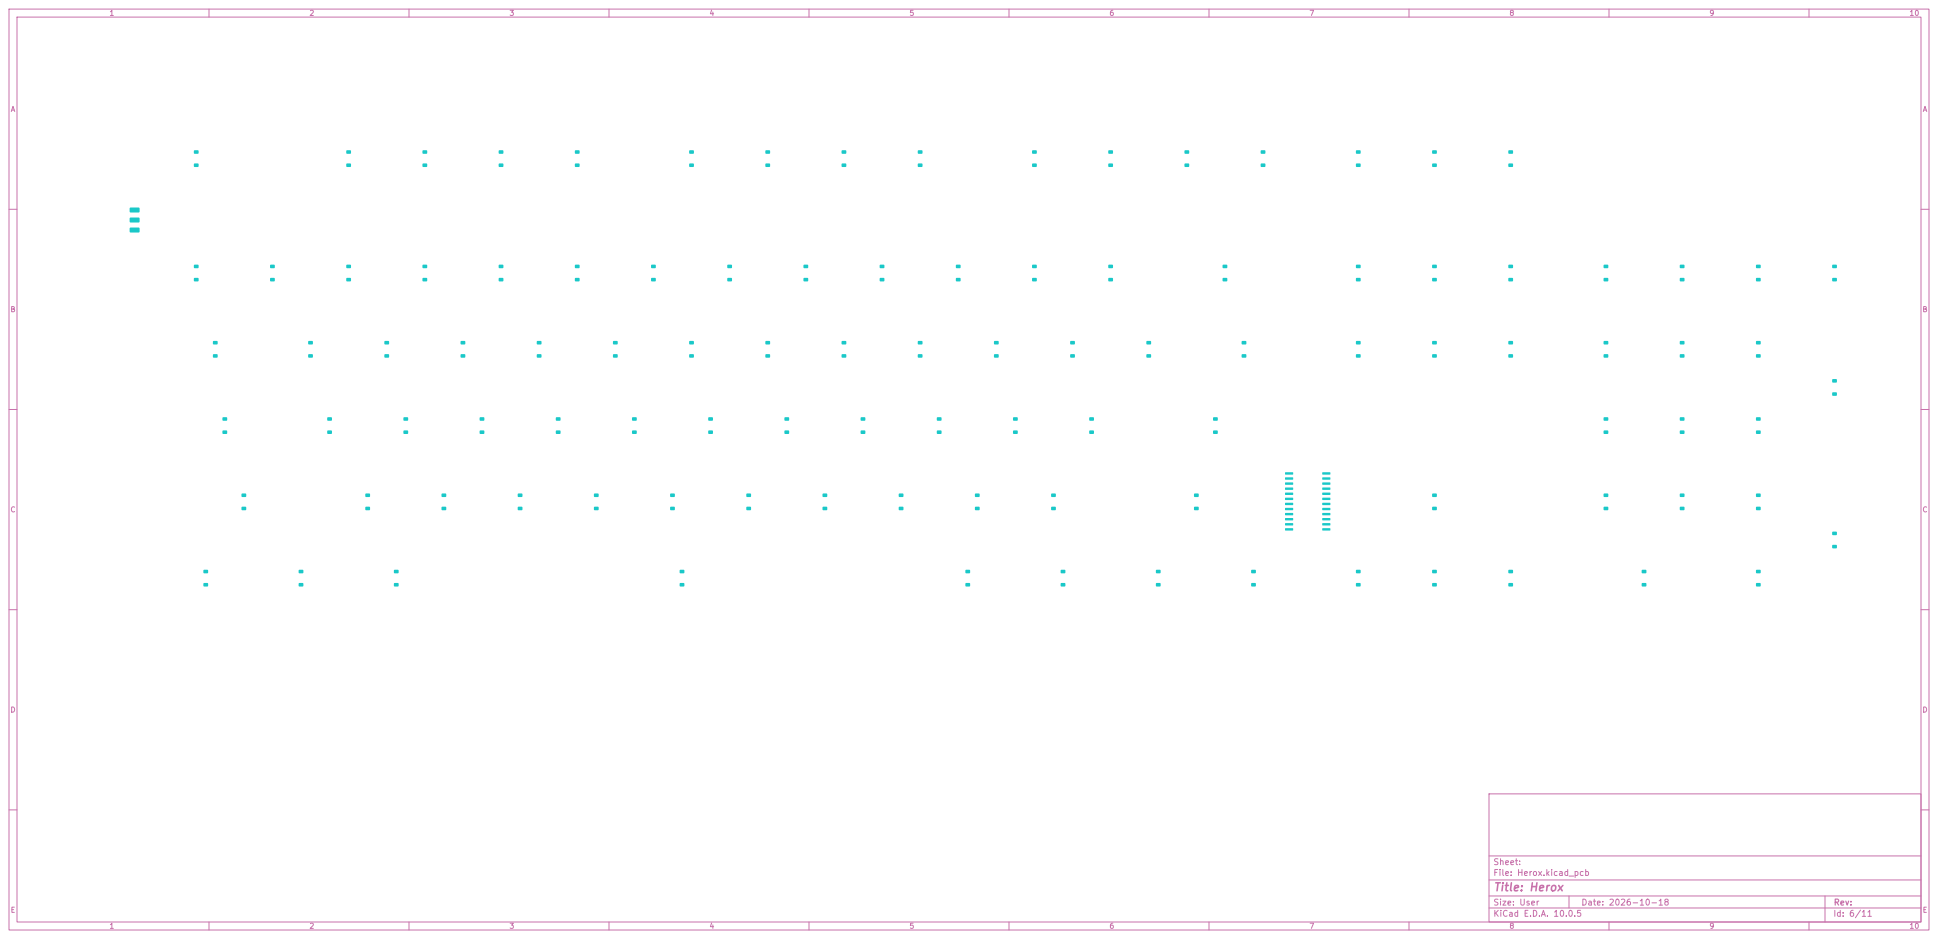
[picture p46: page 6]

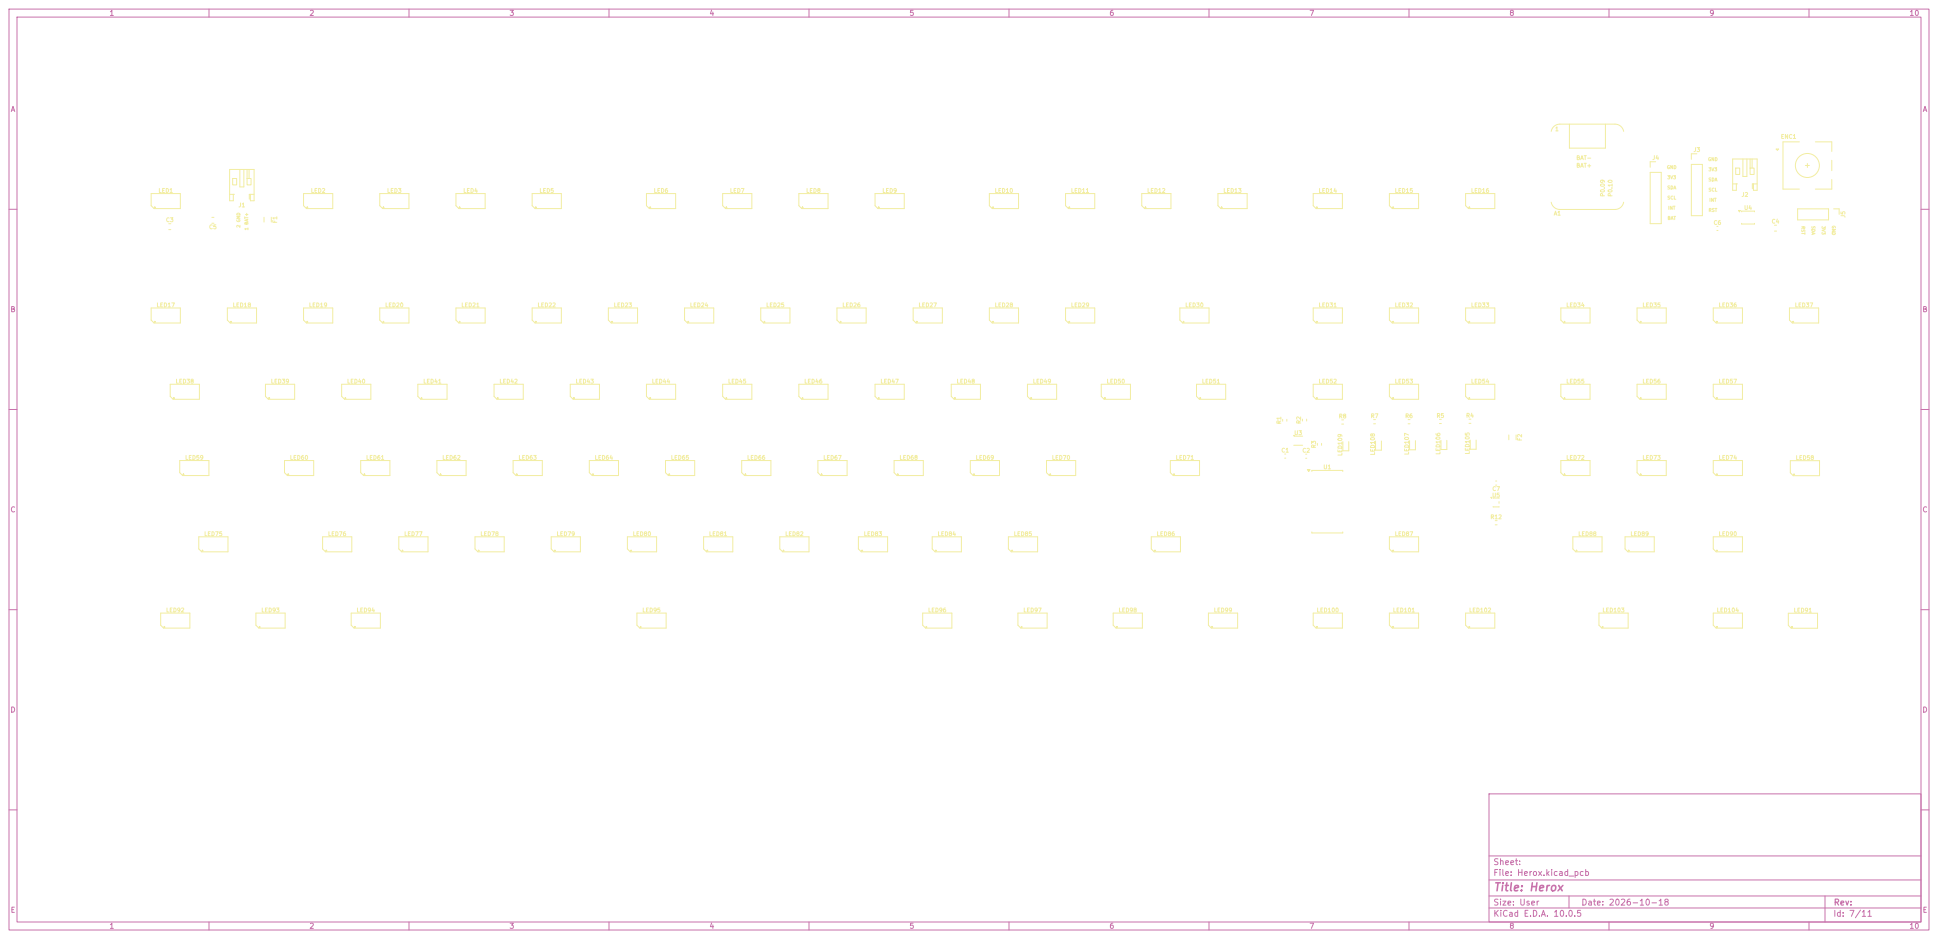
[picture p47: page 7]

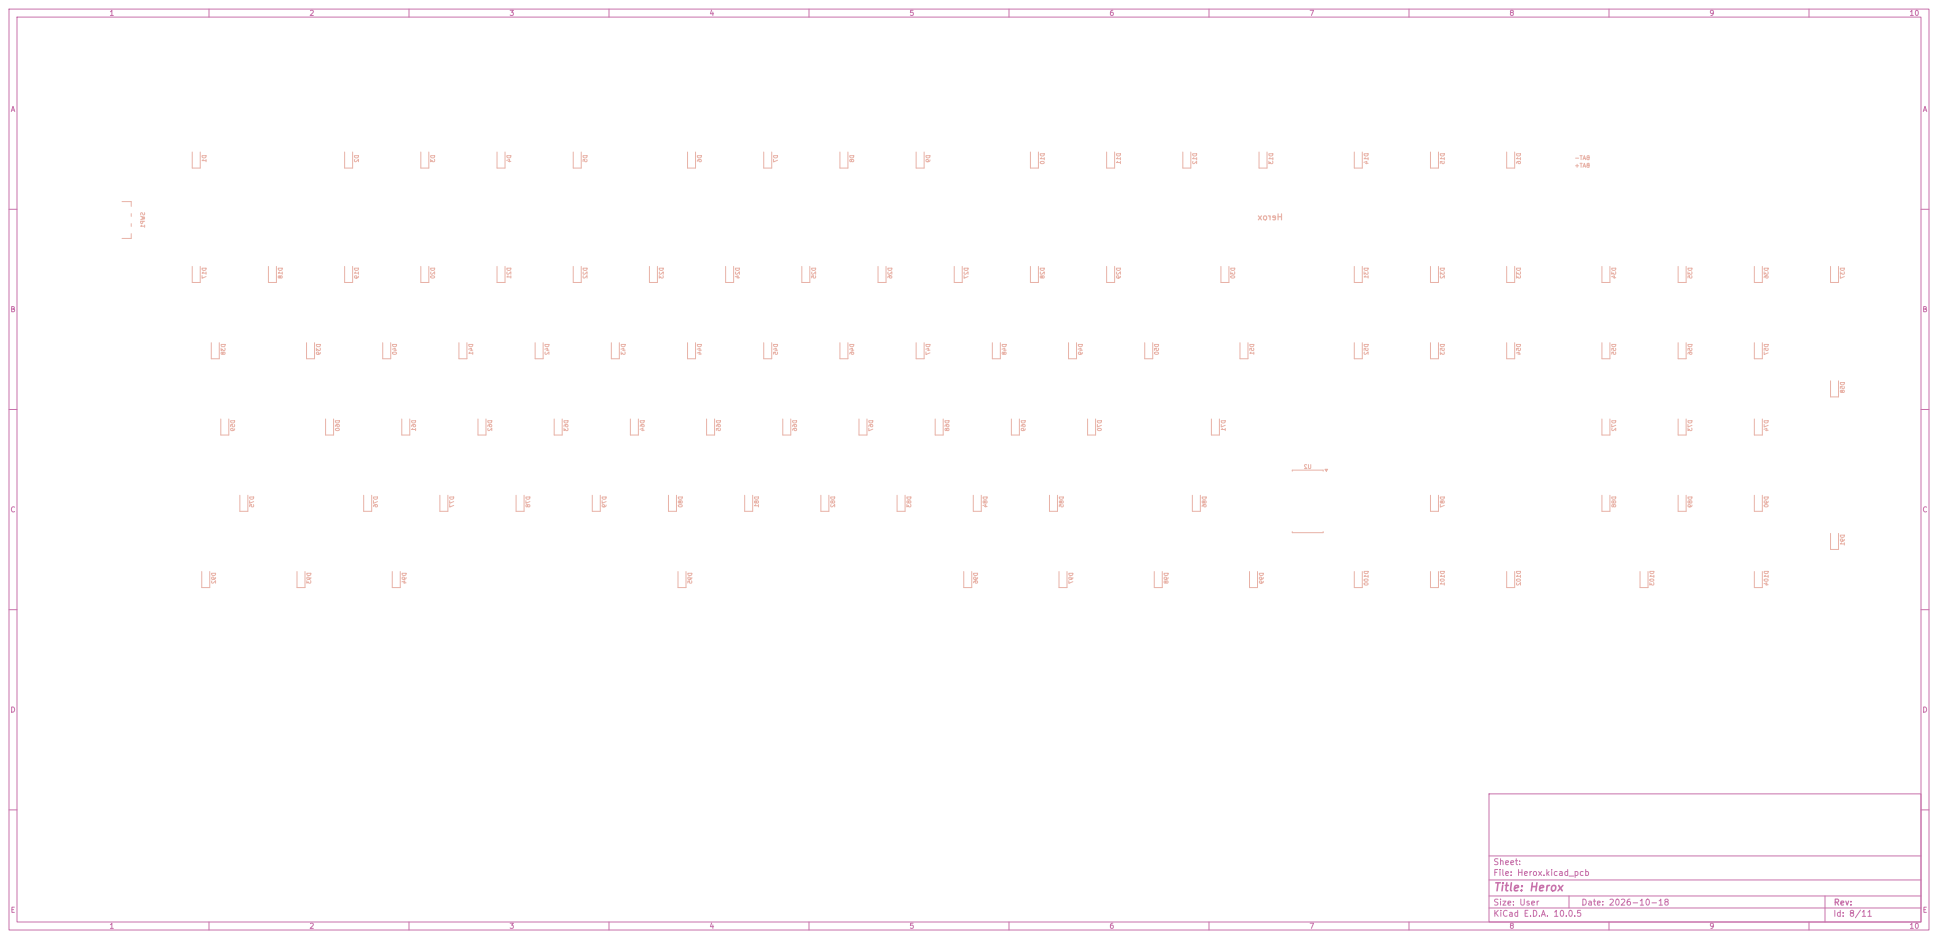
[picture p48: page 8]

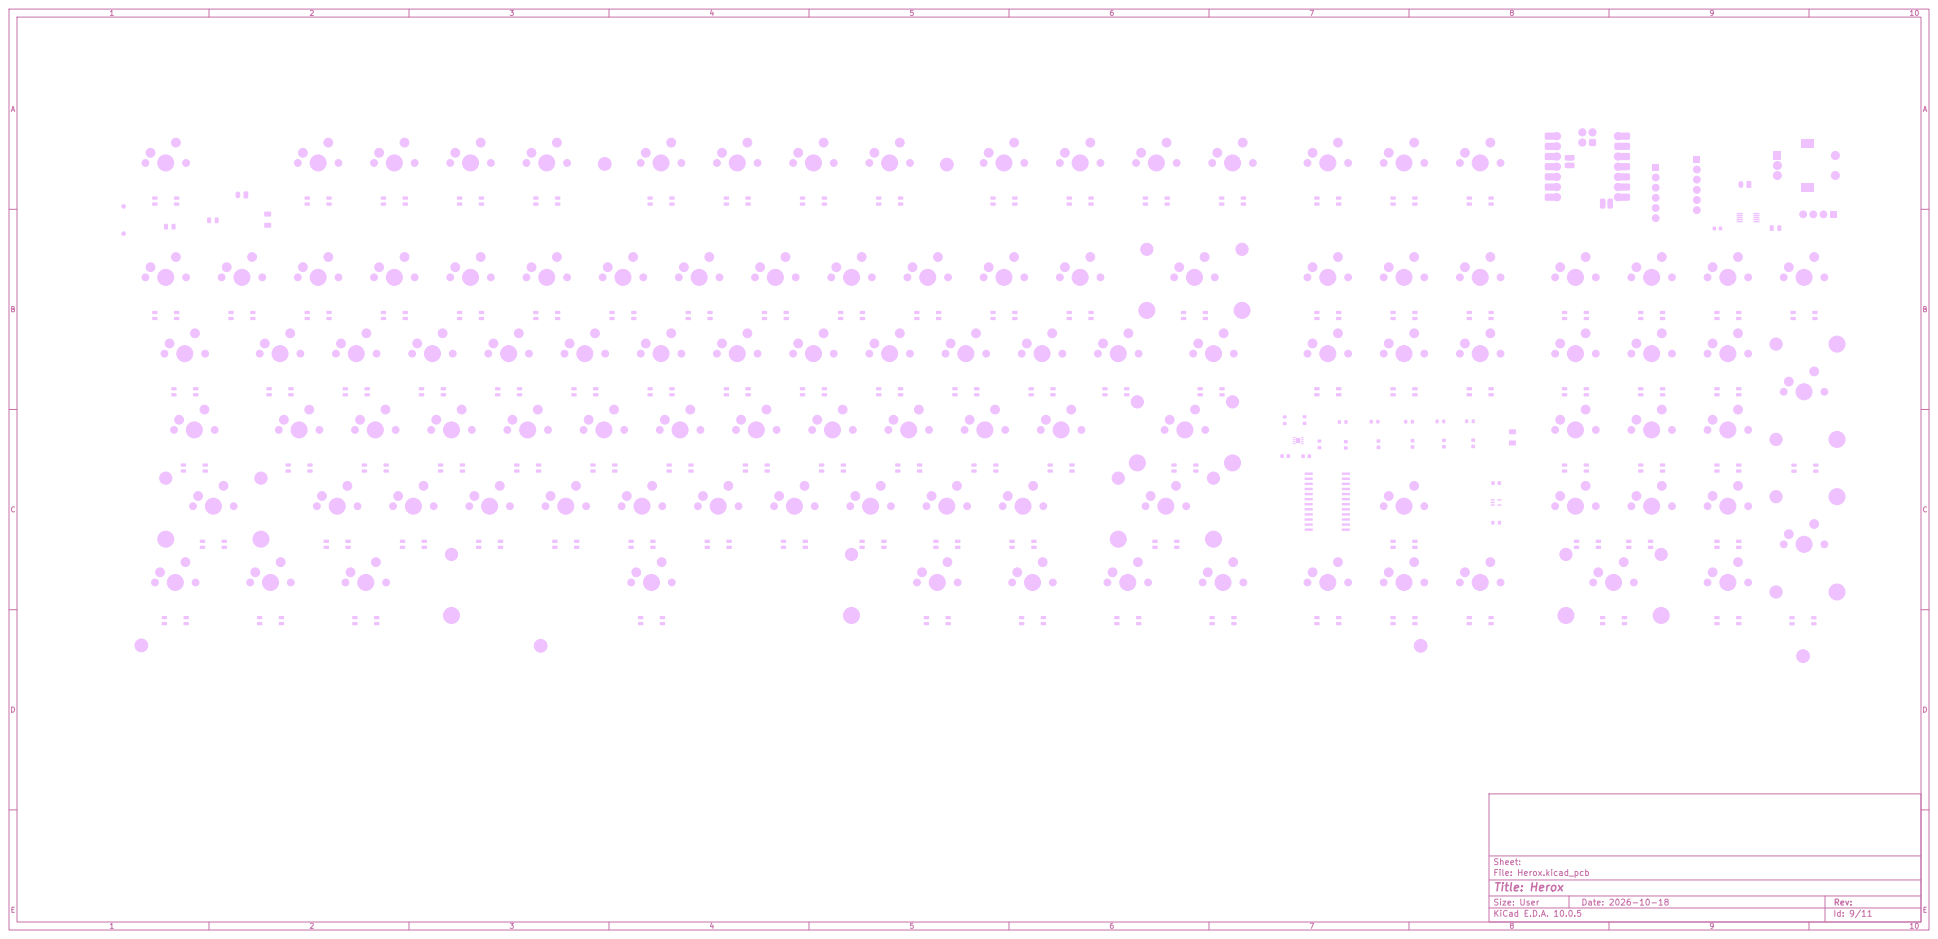
[picture p49: page 9]

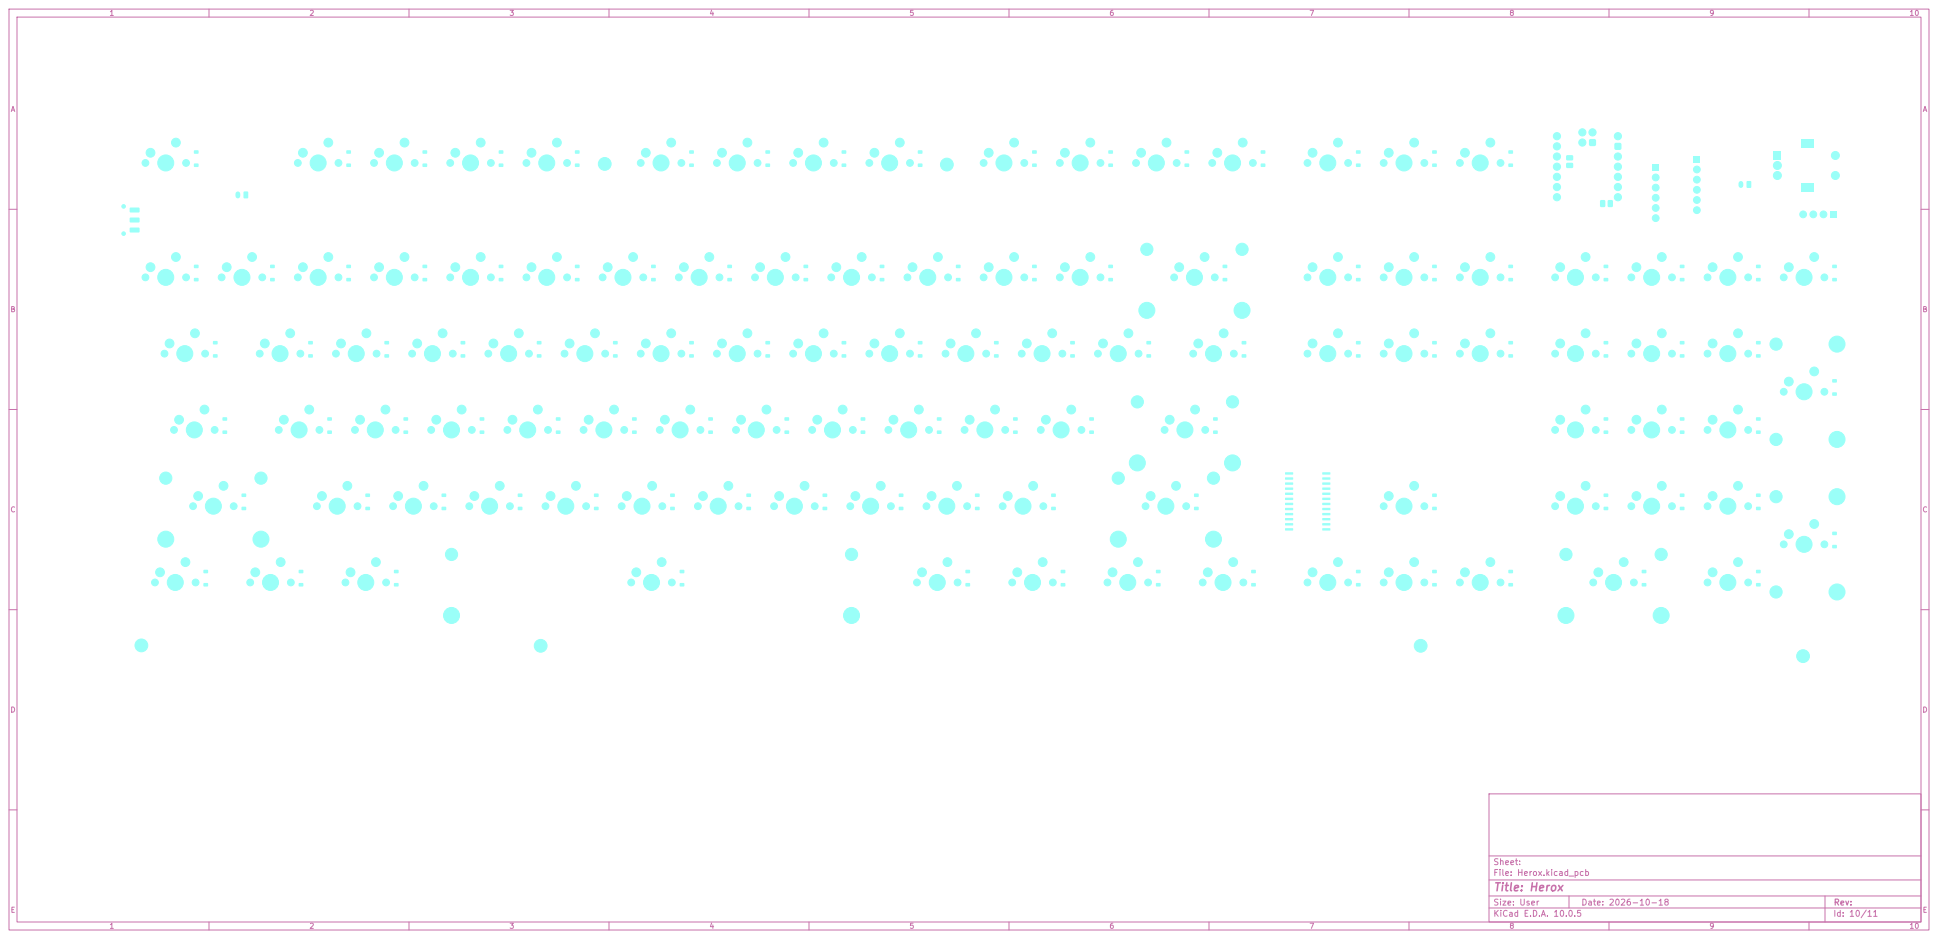
[picture p50: page 10]

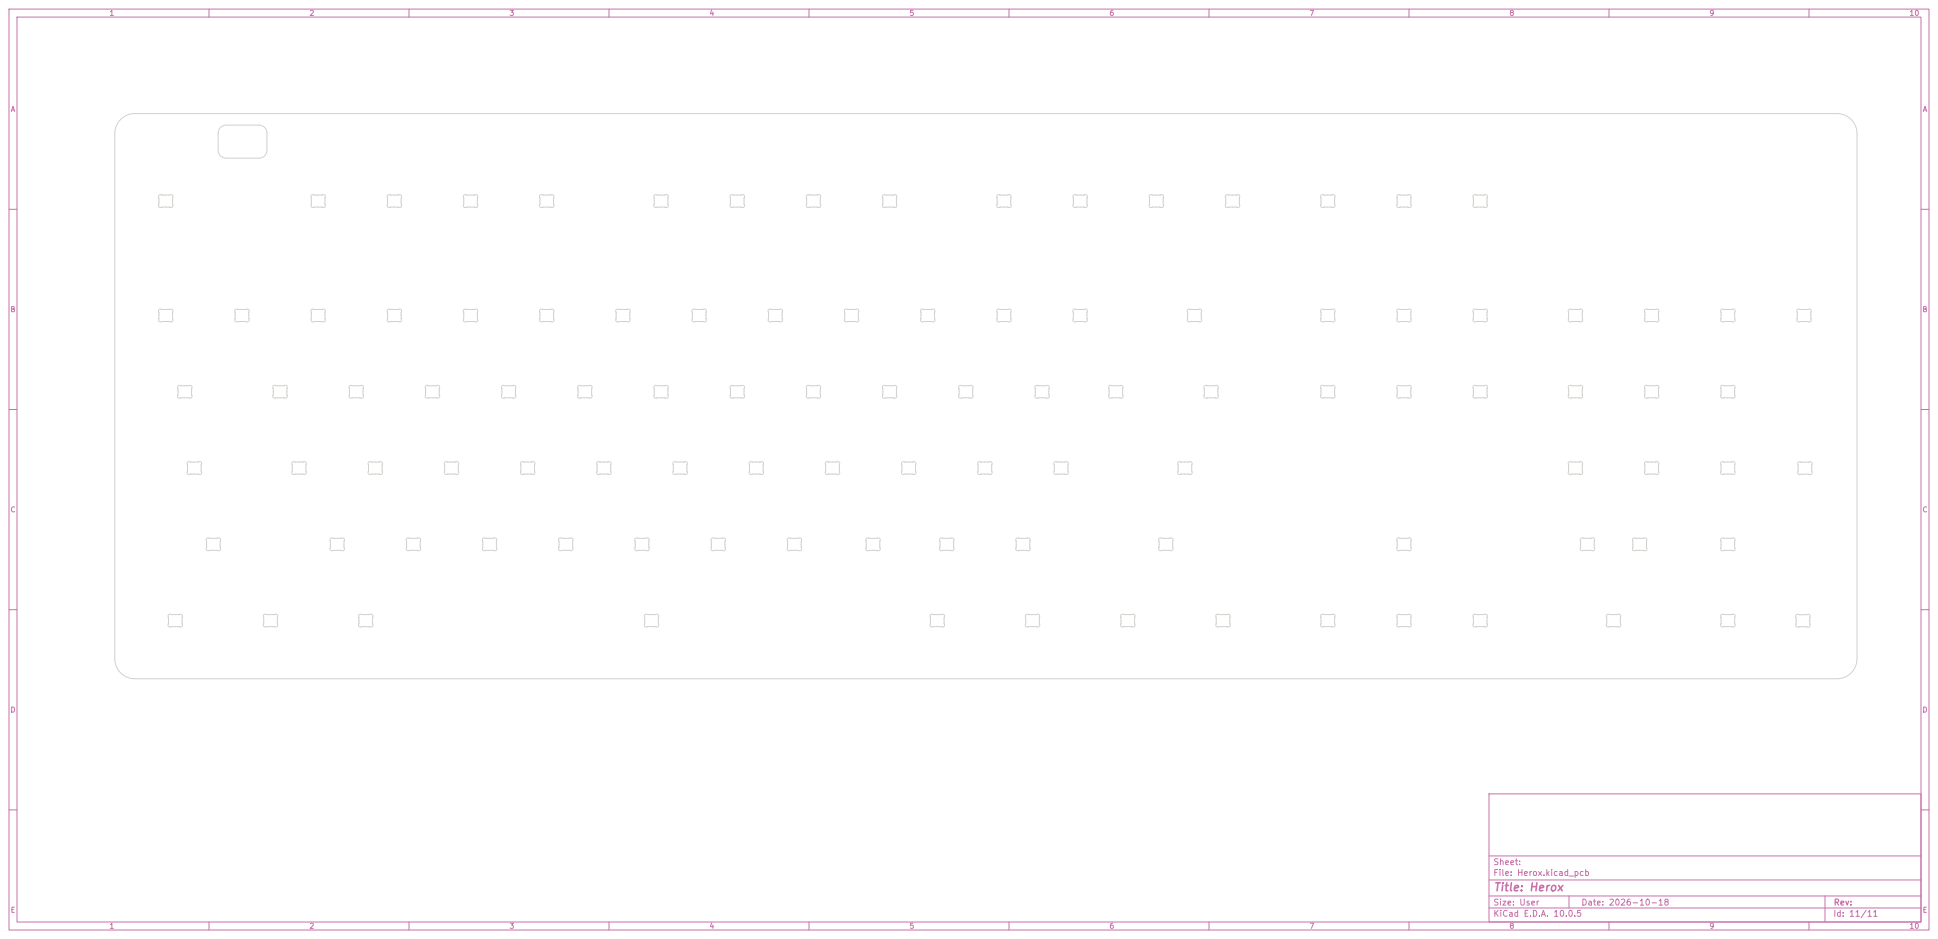
[picture p51: page 11]
