arfanbabaucoder/Herox/PCB/Herox.kicad_pcb

## KiCad design PCB/Herox.kicad_pcb (2026-10-18)

Schematic: Herox.kicad_sch

Parts:
A1: Seeeduino XIAO nRF52840; Xiao_nRF52840_ACH
C1: 100n U1; C_0603_1608Metric
C2: 100n U2; C_0603_1608Metric
C3: 10u BAT; C_0805_2012Metric
C4: 10u MCU; C_0805_2012Metric
C5: 47u RGB; C_0805_2012Metric
C6: 1u DRV REG; C_0603_1608Metric
C7: 100nF X7R; C_0603_1608Metric
D1, D2, D3, D4, D5, D6, D7, D8, D9, D10, D11, D12, D13, D14, D15, D16, D17, D18, D19, D20, D21, D22, D23, D24, D25, D26, D27, D28, D29, D30, D31, D32, D33, D34, D35, D36, D37, D38, D39, D40, D41, D42, D43, D44, D45, D46, D47, D48, D49, D50, D51, D52, D53, D54, D55, D56, D57, D58, D59, D60, D61, D62, D63, D64, D65, D66, D67, D68, D69, D70, D71, D72, D73, D74, D75, D76, D77, D78, D79, D80, D81, D82, D83, D84, D85, D86, D87, D88, D89, D90, D91, D92, D93, D94, D95, D96, D97, D98, D99, D100, D101, D102, D103, D104: 1N4148W; D_SOD-123
ENC1: MEDIA ENCODER; RotaryEncoder_Alps_EC11E-Switch_Vertical_H20mm
F1: PTC 1.1A; Fuse_1206_3216Metric
F2: PTC 0.5A / USB RGB; Fuse_1206_3216Metric; Manufacturer Part Number 0ZCJ0050FF2G
J1: PROTECTED Li-Po 3.7V; JST_PH_S2B-PH-K_1x02_P2.00mm_Horizontal
J2: LRA ACTUATOR; JST_PH_S2B-PH-K_1x02_P2.00mm_Horizontal
J3: LOW-POWER DISPLAY; PinHeader_1x06_P2.54mm_Vertical
J4: AMBIENT SENSOR / EXPANSION; PinHeader_1x06_P2.54mm_Vertical
J5: SWD DEBUG; PinHeader_1x04_P2.54mm_Vertical
LED1, LED2, LED3, LED4, LED5, LED6, LED7, LED8, LED9, LED10, LED11, LED12, LED13, LED14, LED15, LED16, LED17, LED18, LED19, LED20, LED21, LED22, LED23, LED24, LED25, LED26, LED27, LED28, LED29, LED30, LED31, LED32, LED33, LED34, LED35, LED36, LED37, LED38, LED39, LED40, LED41, LED42, LED43, LED44, LED45, LED46, LED47, LED48, LED49, LED50, LED51, LED52, LED53, LED54, LED55, LED56, LED57, LED58, LED59, LED60, LED61, LED62, LED63, LED64, LED65, LED66, LED67, LED68, LED69, LED70, LED71, LED72, LED73, LED74, LED75, LED76, LED77, LED78, LED79, LED80, LED81, LED82, LED83, LED84, LED85, LED86, LED87, LED88, LED89, LED90, LED91, LED92, LED93, LED94, LED95, LED96, LED97, LED98, LED99, LED100, LED101, LED102, LED103, LED104: SK6812MINI-E; LED_SK6812MINI-E_3.2x2.8mm_P1.5mm_ReverseMount
LED105, LED106: XL-1608UGC-04 GREEN; LED_0603_1608Metric
LED107, LED108, LED109: LTST-C193TBKT-5A BLUE; LED_0603_1608Metric
R1: 4.7k SDA; R_0603_1608Metric
R2: 4.7k SCL; R_0603_1608Metric
R3: 10k INT; R_0603_1608Metric
R4, R5, R6, R7, R8: 1k STATUS; R_0603_1608Metric
R12: 33R; R_0603_1608Metric
SW1: Esc; SW_MX_1.00u
SW2: F1; SW_MX_1.00u
SW3: F2; SW_MX_1.00u
SW4: F3; SW_MX_1.00u
SW5: F4; SW_MX_1.00u
SW6: F5; SW_MX_1.00u
SW7: F6; SW_MX_1.00u
SW8: F7; SW_MX_1.00u
SW9: F8; SW_MX_1.00u
SW10: F9; SW_MX_1.00u
SW11: F10; SW_MX_1.00u
SW12: F11; SW_MX_1.00u
SW13: F12; SW_MX_1.00u
SW14: PrtSc; SW_MX_1.00u
SW15: Scroll; SW_MX_1.00u
SW16: Pause; SW_MX_1.00u
SW17: `~; SW_MX_1.00u
SW18: 1!; SW_MX_1.00u
SW19: 2@; SW_MX_1.00u
SW20: 3#; SW_MX_1.00u
SW21: 4$; SW_MX_1.00u
SW22: 5%; SW_MX_1.00u
SW23: 6^; SW_MX_1.00u
SW24: 7&; SW_MX_1.00u
SW25: 8*; SW_MX_1.00u
SW26: 9(; SW_MX_1.00u
SW27: 0); SW_MX_1.00u
SW28: -_; SW_MX_1.00u
SW29: =+; SW_MX_1.00u
SW30: Backspace; SW_MX_2.00u
SW31: Insert; SW_MX_1.00u
SW32: Home; SW_MX_1.00u
SW33: PgUp; SW_MX_1.00u
SW34: Num; SW_MX_1.00u
SW35: /; SW_MX_1.00u
SW36: *; SW_MX_1.00u
SW37: -; SW_MX_1.00u
SW38: Tab; SW_MX_1.50u
SW39: Q; SW_MX_1.00u
SW40: W; SW_MX_1.00u
SW41: E; SW_MX_1.00u
SW42: R; SW_MX_1.00u
SW43: T; SW_MX_1.00u
SW44: Y; SW_MX_1.00u
SW45: U; SW_MX_1.00u
SW46: I; SW_MX_1.00u
SW47: O; SW_MX_1.00u
SW48: P; SW_MX_1.00u
SW49: [{; SW_MX_1.00u
SW50: ]}; SW_MX_1.00u
SW51: \|; SW_MX_1.50u
SW52: Delete; SW_MX_1.00u
SW53: End; SW_MX_1.00u
SW54: PgDn; SW_MX_1.00u
SW55: 7; SW_MX_1.00u
SW56: 8; SW_MX_1.00u
SW57: 9; SW_MX_1.00u
SW58: +; SW_MX_2.00u_Vertical
SW59: Caps; SW_MX_1.75u
SW60: A; SW_MX_1.00u
SW61: S; SW_MX_1.00u
SW62: D; SW_MX_1.00u
SW63: F; SW_MX_1.00u
SW64: G; SW_MX_1.00u
SW65: H; SW_MX_1.00u
SW66: J; SW_MX_1.00u
SW67: K; SW_MX_1.00u
SW68: L; SW_MX_1.00u
SW69: ;:; SW_MX_1.00u
SW70: '"; SW_MX_1.00u
SW71: Enter; SW_MX_2.25u
SW72: 4; SW_MX_1.00u
SW73: 5; SW_MX_1.00u
SW74: 6; SW_MX_1.00u
SW75: LShift; SW_MX_2.25u
SW76: Z; SW_MX_1.00u
SW77: X; SW_MX_1.00u
SW78: C; SW_MX_1.00u
SW79: V; SW_MX_1.00u
SW80: B; SW_MX_1.00u
SW81: N; SW_MX_1.00u
SW82: M; SW_MX_1.00u
SW83: ,<; SW_MX_1.00u
SW84: .>; SW_MX_1.00u
SW85: /?; SW_MX_1.00u
SW86: RShift; SW_MX_2.75u
SW87: Up; SW_MX_1.00u
SW88: 1; SW_MX_1.00u
SW89: 2; SW_MX_1.00u
SW90: 3; SW_MX_1.00u
SW91: NEnter; SW_MX_2.00u_Vertical
SW92: LCtrl; SW_MX_1.25u
SW93: LWin; SW_MX_1.25u
SW94: LAlt; SW_MX_1.25u
SW95: Space; SW_MX_6.25u
SW96: RAlt; SW_MX_1.25u
SW97: RWin; SW_MX_1.25u
SW98: Menu; SW_MX_1.25u
SW99: RCtrl; SW_MX_1.25u
SW100: Left; SW_MX_1.00u
SW101: Down; SW_MX_1.00u
SW102: Right; SW_MX_1.00u
SW103: 0; SW_MX_2.00u
SW104: .; SW_MX_1.00u
SWP1: HARD POWER; SW_SPDT_CK_JS102011SAQN
U1: TCA9555DW / ROW DRIVE; SOIC-24W_7.5x15.4mm_P1.27mm
U2: TCA9555DW / COLUMN SENSE; SOIC-24W_7.5x15.4mm_P1.27mm
U3: MAX17048G+T10 FUEL GAUGE; TDFN-8-1EP_2x2mm_P0.5mm_EP0.8x1.2mm
U4: DRV2605L HAPTIC DRIVER; MSOP-10_3x3mm_P0.5mm
U5: 74LVC1G125GW,125; SOT-353_SC-70-5; Manufacturer Part Number 74LVC1G125GW,125

Connections:
/+3V3: A1.10 (3V3), C1.1, C2.1, C4.1, J3.2, J4.2, J5.2, R1.1, R2.1, R3.1, R4.1, R5.1, R6.1, R7.1, R8.1, U1.24 (VCC), U2.21 (A0), U2.24 (VCC), U4.5 (EN), U4.6 (VDD/NC), U4.10 (VDD)
/+5V_RGB: C5.1, C7.1, F2.2, LED1.3 (VDD), LED2.3 (VDD), LED3.3 (VDD), LED4.3 (VDD), LED5.3 (VDD), LED6.3 (VDD), LED7.3 (VDD), LED8.3 (VDD), LED9.3 (VDD), LED10.3 (VDD), LED11.3 (VDD), LED12.3 (VDD), LED13.3 (VDD), LED14.3 (VDD), LED15.3 (VDD), LED16.3 (VDD), LED17.3 (VDD), LED18.3 (VDD), LED19.3 (VDD), LED20.3 (VDD), LED21.3 (VDD), LED22.3 (VDD), LED23.3 (VDD), LED24.3 (VDD), LED25.3 (VDD), LED26.3 (VDD), LED27.3 (VDD), LED28.3 (VDD), LED29.3 (VDD), LED30.3 (VDD), LED31.3 (VDD), LED32.3 (VDD), LED33.3 (VDD), LED34.3 (VDD), LED35.3 (VDD), LED36.3 (VDD), LED37.3 (VDD), LED38.3 (VDD), LED39.3 (VDD), LED40.3 (VDD), LED41.3 (VDD), LED42.3 (VDD), LED43.3 (VDD), LED44.3 (VDD), LED45.3 (VDD), LED46.3 (VDD), LED47.3 (VDD), LED48.3 (VDD), LED49.3 (VDD), LED50.3 (VDD), LED51.3 (VDD), LED52.3 (VDD), LED53.3 (VDD), LED54.3 (VDD), LED55.3 (VDD), LED56.3 (VDD), LED57.3 (VDD), LED58.3 (VDD), LED59.3 (VDD), LED60.3 (VDD), LED61.3 (VDD), LED62.3 (VDD), LED63.3 (VDD), LED64.3 (VDD), LED65.3 (VDD), LED66.3 (VDD), LED67.3 (VDD), LED68.3 (VDD), LED69.3 (VDD), LED70.3 (VDD), LED71.3 (VDD), LED72.3 (VDD), LED73.3 (VDD), LED74.3 (VDD), LED75.3 (VDD), LED76.3 (VDD), LED77.3 (VDD), LED78.3 (VDD), LED79.3 (VDD), LED80.3 (VDD), LED81.3 (VDD), LED82.3 (VDD), LED83.3 (VDD), LED84.3 (VDD), LED85.3 (VDD), LED86.3 (VDD), LED87.3 (VDD), LED88.3 (VDD), LED89.3 (VDD), LED90.3 (VDD), LED91.3 (VDD), LED92.3 (VDD), LED93.3 (VDD), LED94.3 (VDD), LED95.3 (VDD), LED96.3 (VDD), LED97.3 (VDD), LED98.3 (VDD), LED99.3 (VDD), LED100.3 (VDD), LED101.3 (VDD), LED102.3 (VDD), LED103.3 (VDD), LED104.3 (VDD), U5.5 (VCC)
/COL0: SW1.1, SW14.1, SW27.1, SW40.1, SW53.1, SW66.1, SW79.1, SW92.1, U2.4 (P00)
/COL1: SW2.1, SW15.1, SW28.1, SW41.1, SW54.1, SW67.1, SW80.1, SW93.1, U2.5 (P01)
/COL2: SW3.1, SW16.1, SW29.1, SW42.1, SW55.1, SW68.1, SW81.1, SW94.1, U2.6 (P02)
/COL3: SW4.1, SW17.1, SW30.1, SW43.1, SW56.1, SW69.1, SW82.1, SW95.1, U2.7 (P03)
/COL4: SW5.1, SW18.1, SW31.1, SW44.1, SW57.1, SW70.1, SW83.1, SW96.1, U2.8 (P04)
/COL5: SW6.1, SW19.1, SW32.1, SW45.1, SW58.1, SW71.1, SW84.1, SW97.1, U2.9 (P05)
/COL6: SW7.1, SW20.1, SW33.1, SW46.1, SW59.1, SW72.1, SW85.1, SW98.1, U2.10 (P06)
/COL7: SW8.1, SW21.1, SW34.1, SW47.1, SW60.1, SW73.1, SW86.1, SW99.1, U2.11 (P07)
/COL8: SW9.1, SW22.1, SW35.1, SW48.1, SW61.1, SW74.1, SW87.1, SW100.1, U2.13 (P10)
/COL9: SW10.1, SW23.1, SW36.1, SW49.1, SW62.1, SW75.1, SW88.1, SW101.1, U2.14 (P11)
/COL10: SW11.1, SW24.1, SW37.1, SW50.1, SW63.1, SW76.1, SW89.1, SW102.1, U2.15 (P12)
/COL11: SW12.1, SW25.1, SW38.1, SW51.1, SW64.1, SW77.1, SW90.1, SW103.1, U2.16 (P13)
/COL12: SW13.1, SW26.1, SW39.1, SW52.1, SW65.1, SW78.1, SW91.1, SW104.1, U2.17 (P14)
/DISP_INT: A1.11 (P1.15), J3.5
/DRV_REG: C6.1, U4.1 (REG)
/ENC_A: A1.3 (P0.28), ENC1.A
/ENC_B: A1.4 (P0.29), ENC1.C
/ENC_SW: A1.7 (P1.11), ENC1.S1
/EX_INT: A1.2 (P0.03), J4.5, R3.2, U1.1 (~INT), U2.1 (~INT)
/FUEL_INT: A1.12 (P1.14), U3.5
/GND: A1.9 (GND), A1.15 (BAT-), A1.22 (GND), C1.2, C2.2, C3.2, C4.2, C5.2, C6.2, C7.2, ENC1.B, ENC1.S2, J1.2, J3.1, J4.1, J5.1, LED1.1 (VSS), LED2.1 (VSS), LED3.1 (VSS), LED4.1 (VSS), LED5.1 (VSS), LED6.1 (VSS), LED7.1 (VSS), LED8.1 (VSS), LED9.1 (VSS), LED10.1 (VSS), LED11.1 (VSS), LED12.1 (VSS), LED13.1 (VSS), LED14.1 (VSS), LED15.1 (VSS), LED16.1 (VSS), LED17.1 (VSS), LED18.1 (VSS), LED19.1 (VSS), LED20.1 (VSS), LED21.1 (VSS), LED22.1 (VSS), LED23.1 (VSS), LED24.1 (VSS), LED25.1 (VSS), LED26.1 (VSS), LED27.1 (VSS), LED28.1 (VSS), LED29.1 (VSS), LED30.1 (VSS), LED31.1 (VSS), LED32.1 (VSS), LED33.1 (VSS), LED34.1 (VSS), LED35.1 (VSS), LED36.1 (VSS), LED37.1 (VSS), LED38.1 (VSS), LED39.1 (VSS), LED40.1 (VSS), LED41.1 (VSS), LED42.1 (VSS), LED43.1 (VSS), LED44.1 (VSS), LED45.1 (VSS), LED46.1 (VSS), LED47.1 (VSS), LED48.1 (VSS), LED49.1 (VSS), LED50.1 (VSS), LED51.1 (VSS), LED52.1 (VSS), LED53.1 (VSS), LED54.1 (VSS), LED55.1 (VSS), LED56.1 (VSS), LED57.1 (VSS), LED58.1 (VSS), LED59.1 (VSS), LED60.1 (VSS), LED61.1 (VSS), LED62.1 (VSS), LED63.1 (VSS), LED64.1 (VSS), LED65.1 (VSS), LED66.1 (VSS), LED67.1 (VSS), LED68.1 (VSS), LED69.1 (VSS), LED70.1 (VSS), LED71.1 (VSS), LED72.1 (VSS), LED73.1 (VSS), LED74.1 (VSS), LED75.1 (VSS), LED76.1 (VSS), LED77.1 (VSS), LED78.1 (VSS), LED79.1 (VSS), LED80.1 (VSS), LED81.1 (VSS), LED82.1 (VSS), LED83.1 (VSS), LED84.1 (VSS), LED85.1 (VSS), LED86.1 (VSS), LED87.1 (VSS), LED88.1 (VSS), LED89.1 (VSS), LED90.1 (VSS), LED91.1 (VSS), LED92.1 (VSS), LED93.1 (VSS), LED94.1 (VSS), LED95.1 (VSS), LED96.1 (VSS), LED97.1 (VSS), LED98.1 (VSS), LED99.1 (VSS), LED100.1 (VSS), LED101.1 (VSS), LED102.1 (VSS), LED103.1 (VSS), LED104.1 (VSS), U1.2 (A1), U1.3 (A2), U1.12 (GND), U1.21 (A0), U2.2 (A1), U2.3 (A2), U2.12 (GND), U3.3, U3.4, U3.9, U4.4 (IN/TRIG), U4.8 (GND), U5.1, U5.3 (GND)
/HAPTIC_N: J2.2, U4.9 (OUT-)
/HAPTIC_P: J2.1, U4.7 (OUT+)
/I2C_SCL: A1.6 (P0.05), J3.4, J4.4, R2.2, U1.22 (SCL), U2.22 (SCL), U3.7, U4.2 (SCL)
/I2C_SDA: A1.5 (P0.04), J3.3, J4.3, J5.3, R1.2, U1.23 (SDA), U2.23 (SDA), U3.6, U4.3 (SDA)
/IND_BLE1_N: LED107.1 (K), U1.15 (P12)
/IND_BLE2_N: LED108.1 (K), U1.16 (P13)
/IND_BLE3_N: LED109.1 (K), U1.17 (P14)
/IND_CAPS_N: LED105.1 (K), U1.13 (P10)
/IND_NUM_N: LED106.1 (K), U1.14 (P11)
/KSW1: D1.2 (A), SW1.2
/KSW2: D2.2 (A), SW2.2
/KSW3: D3.2 (A), SW3.2
/KSW4: D4.2 (A), SW4.2
/KSW5: D5.2 (A), SW5.2
/KSW6: D6.2 (A), SW6.2
/KSW7: D7.2 (A), SW7.2
/KSW8: D8.2 (A), SW8.2
/KSW9: D9.2 (A), SW9.2
/KSW10: D10.2 (A), SW10.2
/KSW11: D11.2 (A), SW11.2
/KSW12: D12.2 (A), SW12.2
/KSW13: D13.2 (A), SW13.2
/KSW14: D14.2 (A), SW14.2
/KSW15: D15.2 (A), SW15.2
/KSW16: D16.2 (A), SW16.2
/KSW17: D17.2 (A), SW17.2
/KSW18: D18.2 (A), SW18.2
/KSW19: D19.2 (A), SW19.2
/KSW20: D20.2 (A), SW20.2
/KSW21: D21.2 (A), SW21.2
/KSW22: D22.2 (A), SW22.2
/KSW23: D23.2 (A), SW23.2
/KSW24: D24.2 (A), SW24.2
/KSW25: D25.2 (A), SW25.2
/KSW26: D26.2 (A), SW26.2
/KSW27: D27.2 (A), SW27.2
/KSW28: D28.2 (A), SW28.2
/KSW29: D29.2 (A), SW29.2
/KSW30: D30.2 (A), SW30.2
/KSW31: D31.2 (A), SW31.2
/KSW32: D32.2 (A), SW32.2
/KSW33: D33.2 (A), SW33.2
/KSW34: D34.2 (A), SW34.2
/KSW35: D35.2 (A), SW35.2
/KSW36: D36.2 (A), SW36.2
/KSW37: D37.2 (A), SW37.2
/KSW38: D38.2 (A), SW38.2
/KSW39: D39.2 (A), SW39.2
/KSW40: D40.2 (A), SW40.2
/KSW41: D41.2 (A), SW41.2
/KSW42: D42.2 (A), SW42.2
/KSW43: D43.2 (A), SW43.2
/KSW44: D44.2 (A), SW44.2
/KSW45: D45.2 (A), SW45.2
/KSW46: D46.2 (A), SW46.2
/KSW47: D47.2 (A), SW47.2
/KSW48: D48.2 (A), SW48.2
/KSW49: D49.2 (A), SW49.2
/KSW50: D50.2 (A), SW50.2
/KSW51: D51.2 (A), SW51.2
/KSW52: D52.2 (A), SW52.2
/KSW53: D53.2 (A), SW53.2
/KSW54: D54.2 (A), SW54.2
/KSW55: D55.2 (A), SW55.2
/KSW56: D56.2 (A), SW56.2
/KSW57: D57.2 (A), SW57.2
/KSW58: D58.2 (A), SW58.2
/KSW59: D59.2 (A), SW59.2
/KSW60: D60.2 (A), SW60.2
/KSW61: D61.2 (A), SW61.2
/KSW62: D62.2 (A), SW62.2
/KSW63: D63.2 (A), SW63.2
/KSW64: D64.2 (A), SW64.2
/KSW65: D65.2 (A), SW65.2
/KSW66: D66.2 (A), SW66.2
/KSW67: D67.2 (A), SW67.2
/KSW68: D68.2 (A), SW68.2
/KSW69: D69.2 (A), SW69.2
/KSW70: D70.2 (A), SW70.2
/KSW71: D71.2 (A), SW71.2
/KSW72: D72.2 (A), SW72.2
/KSW73: D73.2 (A), SW73.2
/KSW74: D74.2 (A), SW74.2
/KSW75: D75.2 (A), SW75.2
/KSW76: D76.2 (A), SW76.2
/KSW77: D77.2 (A), SW77.2
/KSW78: D78.2 (A), SW78.2
/KSW79: D79.2 (A), SW79.2
/KSW80: D80.2 (A), SW80.2
/KSW81: D81.2 (A), SW81.2
/KSW82: D82.2 (A), SW82.2
/KSW83: D83.2 (A), SW83.2
/KSW84: D84.2 (A), SW84.2
/KSW85: D85.2 (A), SW85.2
/KSW86: D86.2 (A), SW86.2
/KSW87: D87.2 (A), SW87.2
/KSW88: D88.2 (A), SW88.2
/KSW89: D89.2 (A), SW89.2
/KSW90: D90.2 (A), SW90.2
/KSW91: D91.2 (A), SW91.2
/KSW92: D92.2 (A), SW92.2
/KSW93: D93.2 (A), SW93.2
/KSW94: D94.2 (A), SW94.2
/KSW95: D95.2 (A), SW95.2
/KSW96: D96.2 (A), SW96.2
/KSW97: D97.2 (A), SW97.2
/KSW98: D98.2 (A), SW98.2
/KSW99: D99.2 (A), SW99.2
/KSW100: D100.2 (A), SW100.2
/KSW101: D101.2 (A), SW101.2
/KSW102: D102.2 (A), SW102.2
/KSW103: D103.2 (A), SW103.2
/KSW104: D104.2 (A), SW104.2
/NRST: A1.21 (RST), J3.6, J5.4
/RGB_1: LED1.4 (DOUT), LED2.2 (DIN)
/RGB_2: LED2.4 (DOUT), LED3.2 (DIN)
/RGB_3: LED3.4 (DOUT), LED4.2 (DIN)
/RGB_4: LED4.4 (DOUT), LED5.2 (DIN)
/RGB_5: LED5.4 (DOUT), LED6.2 (DIN)
/RGB_6: LED6.4 (DOUT), LED7.2 (DIN)
/RGB_7: LED7.4 (DOUT), LED8.2 (DIN)
/RGB_8: LED8.4 (DOUT), LED9.2 (DIN)
/RGB_9: LED9.4 (DOUT), LED10.2 (DIN)
/RGB_10: LED10.4 (DOUT), LED11.2 (DIN)
/RGB_11: LED11.4 (DOUT), LED12.2 (DIN)
/RGB_12: LED12.4 (DOUT), LED13.2 (DIN)
/RGB_13: LED13.4 (DOUT), LED14.2 (DIN)
/RGB_14: LED14.4 (DOUT), LED15.2 (DIN)
/RGB_15: LED15.4 (DOUT), LED16.2 (DIN)
/RGB_16: LED16.4 (DOUT), LED17.2 (DIN)
/RGB_17: LED17.4 (DOUT), LED18.2 (DIN)
/RGB_18: LED18.4 (DOUT), LED19.2 (DIN)
/RGB_19: LED19.4 (DOUT), LED20.2 (DIN)
/RGB_20: LED20.4 (DOUT), LED21.2 (DIN)
/RGB_21: LED21.4 (DOUT), LED22.2 (DIN)
/RGB_22: LED22.4 (DOUT), LED23.2 (DIN)
/RGB_23: LED23.4 (DOUT), LED24.2 (DIN)
/RGB_24: LED24.4 (DOUT), LED25.2 (DIN)
/RGB_25: LED25.4 (DOUT), LED26.2 (DIN)
/RGB_26: LED26.4 (DOUT), LED27.2 (DIN)
/RGB_27: LED27.4 (DOUT), LED28.2 (DIN)
/RGB_28: LED28.4 (DOUT), LED29.2 (DIN)
/RGB_29: LED29.4 (DOUT), LED30.2 (DIN)
/RGB_30: LED30.4 (DOUT), LED31.2 (DIN)
/RGB_31: LED31.4 (DOUT), LED32.2 (DIN)
/RGB_32: LED32.4 (DOUT), LED33.2 (DIN)
/RGB_33: LED33.4 (DOUT), LED34.2 (DIN)
/RGB_34: LED34.4 (DOUT), LED35.2 (DIN)
/RGB_35: LED35.4 (DOUT), LED36.2 (DIN)
/RGB_36: LED36.4 (DOUT), LED37.2 (DIN)
/RGB_37: LED37.4 (DOUT), LED38.2 (DIN)
/RGB_38: LED38.4 (DOUT), LED39.2 (DIN)
/RGB_39: LED39.4 (DOUT), LED40.2 (DIN)
/RGB_40: LED40.4 (DOUT), LED41.2 (DIN)
/RGB_41: LED41.4 (DOUT), LED42.2 (DIN)
/RGB_42: LED42.4 (DOUT), LED43.2 (DIN)
/RGB_43: LED43.4 (DOUT), LED44.2 (DIN)
/RGB_44: LED44.4 (DOUT), LED45.2 (DIN)
/RGB_45: LED45.4 (DOUT), LED46.2 (DIN)
/RGB_46: LED46.4 (DOUT), LED47.2 (DIN)
/RGB_47: LED47.4 (DOUT), LED48.2 (DIN)
/RGB_48: LED48.4 (DOUT), LED49.2 (DIN)
/RGB_49: LED49.4 (DOUT), LED50.2 (DIN)
/RGB_50: LED50.4 (DOUT), LED51.2 (DIN)
/RGB_51: LED51.4 (DOUT), LED52.2 (DIN)
/RGB_52: LED52.4 (DOUT), LED53.2 (DIN)
/RGB_53: LED53.4 (DOUT), LED54.2 (DIN)
/RGB_54: LED54.4 (DOUT), LED55.2 (DIN)
/RGB_55: LED55.4 (DOUT), LED56.2 (DIN)
/RGB_56: LED56.4 (DOUT), LED57.2 (DIN)
/RGB_57: LED57.4 (DOUT), LED58.2 (DIN)
/RGB_58: LED58.4 (DOUT), LED59.2 (DIN)
/RGB_59: LED59.4 (DOUT), LED60.2 (DIN)
/RGB_60: LED60.4 (DOUT), LED61.2 (DIN)
/RGB_61: LED61.4 (DOUT), LED62.2 (DIN)
/RGB_62: LED62.4 (DOUT), LED63.2 (DIN)
/RGB_63: LED63.4 (DOUT), LED64.2 (DIN)
/RGB_64: LED64.4 (DOUT), LED65.2 (DIN)
/RGB_65: LED65.4 (DOUT), LED66.2 (DIN)
/RGB_66: LED66.4 (DOUT), LED67.2 (DIN)
/RGB_67: LED67.4 (DOUT), LED68.2 (DIN)
/RGB_68: LED68.4 (DOUT), LED69.2 (DIN)
/RGB_69: LED69.4 (DOUT), LED70.2 (DIN)
/RGB_70: LED70.4 (DOUT), LED71.2 (DIN)
/RGB_71: LED71.4 (DOUT), LED72.2 (DIN)
/RGB_72: LED72.4 (DOUT), LED73.2 (DIN)
/RGB_73: LED73.4 (DOUT), LED74.2 (DIN)
/RGB_74: LED74.4 (DOUT), LED75.2 (DIN)
/RGB_75: LED75.4 (DOUT), LED76.2 (DIN)
/RGB_76: LED76.4 (DOUT), LED77.2 (DIN)
/RGB_77: LED77.4 (DOUT), LED78.2 (DIN)
/RGB_78: LED78.4 (DOUT), LED79.2 (DIN)
/RGB_79: LED79.4 (DOUT), LED80.2 (DIN)
/RGB_80: LED80.4 (DOUT), LED81.2 (DIN)
/RGB_81: LED81.4 (DOUT), LED82.2 (DIN)
/RGB_82: LED82.4 (DOUT), LED83.2 (DIN)
/RGB_83: LED83.4 (DOUT), LED84.2 (DIN)
/RGB_84: LED84.4 (DOUT), LED85.2 (DIN)
/RGB_85: LED85.4 (DOUT), LED86.2 (DIN)
/RGB_86: LED86.4 (DOUT), LED87.2 (DIN)
/RGB_87: LED87.4 (DOUT), LED88.2 (DIN)
/RGB_88: LED88.4 (DOUT), LED89.2 (DIN)
/RGB_89: LED89.4 (DOUT), LED90.2 (DIN)
/RGB_90: LED90.4 (DOUT), LED91.2 (DIN)
/RGB_91: LED91.4 (DOUT), LED92.2 (DIN)
/RGB_92: LED92.4 (DOUT), LED93.2 (DIN)
/RGB_93: LED93.4 (DOUT), LED94.2 (DIN)
/RGB_94: LED94.4 (DOUT), LED95.2 (DIN)
/RGB_95: LED95.4 (DOUT), LED96.2 (DIN)
/RGB_96: LED96.4 (DOUT), LED97.2 (DIN)
/RGB_97: LED97.4 (DOUT), LED98.2 (DIN)
/RGB_98: LED98.4 (DOUT), LED99.2 (DIN)
/RGB_99: LED99.4 (DOUT), LED100.2 (DIN)
/RGB_100: LED100.4 (DOUT), LED101.2 (DIN)
/RGB_101: LED101.4 (DOUT), LED102.2 (DIN)
/RGB_102: LED102.4 (DOUT), LED103.2 (DIN)
/RGB_103: LED103.4 (DOUT), LED104.2 (DIN)
/RGB_DATA: LED1.2 (DIN), R12.2
/RGB_DATA_3V3: A1.1 (P0.02), U5.2
/ROW0: D1.1 (K), D2.1 (K), D3.1 (K), D4.1 (K), D5.1 (K), D6.1 (K), D7.1 (K), D8.1 (K), D9.1 (K), D10.1 (K), D11.1 (K), D12.1 (K), D13.1 (K), U1.4 (P00)
/ROW1: D14.1 (K), D15.1 (K), D16.1 (K), D17.1 (K), D18.1 (K), D19.1 (K), D20.1 (K), D21.1 (K), D22.1 (K), D23.1 (K), D24.1 (K), D25.1 (K), D26.1 (K), U1.5 (P01)
/ROW2: D27.1 (K), D28.1 (K), D29.1 (K), D30.1 (K), D31.1 (K), D32.1 (K), D33.1 (K), D34.1 (K), D35.1 (K), D36.1 (K), D37.1 (K), D38.1 (K), D39.1 (K), U1.6 (P02)
/ROW3: D40.1 (K), D41.1 (K), D42.1 (K), D43.1 (K), D44.1 (K), D45.1 (K), D46.1 (K), D47.1 (K), D48.1 (K), D49.1 (K), D50.1 (K), D51.1 (K), D52.1 (K), U1.7 (P03)
/ROW4: D53.1 (K), D54.1 (K), D55.1 (K), D56.1 (K), D57.1 (K), D58.1 (K), D59.1 (K), D60.1 (K), D61.1 (K), D62.1 (K), D63.1 (K), D64.1 (K), D65.1 (K), U1.8 (P04)
/ROW5: D66.1 (K), D67.1 (K), D68.1 (K), D69.1 (K), D70.1 (K), D71.1 (K), D72.1 (K), D73.1 (K), D74.1 (K), D75.1 (K), D76.1 (K), D77.1 (K), D78.1 (K), U1.9 (P05)
/ROW6: D79.1 (K), D80.1 (K), D81.1 (K), D82.1 (K), D83.1 (K), D84.1 (K), D85.1 (K), D86.1 (K), D87.1 (K), D88.1 (K), D89.1 (K), D90.1 (K), D91.1 (K), U1.10 (P06)
/ROW7: D92.1 (K), D93.1 (K), D94.1 (K), D95.1 (K), D96.1 (K), D97.1 (K), D98.1 (K), D99.1 (K), D100.1 (K), D101.1 (K), D102.1 (K), D103.1 (K), D104.1 (K), U1.11 (P07)
/USB_VBUS_5V: A1.8 (5V), F2.1
/VBAT_FUSED: F1.2, SWP1.1 (A)
/VBAT_RAW: F1.1, J1.1
/VBAT_SW: A1.16 (BAT+), C3.1, J4.6, SWP1.2 (B), U3.2, U3.8
unnamed: LED105.2 (A), R4.2
unnamed: LED106.2 (A), R5.2
unnamed: LED107.2 (A), R6.2
unnamed: LED108.2 (A), R7.2
unnamed: LED109.2 (A), R8.2
unnamed: R12.1, U5.4

Notes on the sheet:
ROW0
COL8
+5V_RGB
COL7
CAPS LOCK
COL1
NUM LOCK
BLE HOST 2
GND
COL2
COL10
COL5
COL9
ROW6
ROW1
BLE HOST 3
COL12
COL3
ROW2
ROW3
ROW4
COL6
BLE HOST 1
COL11
ROW5
COL0
COL4
ROW7

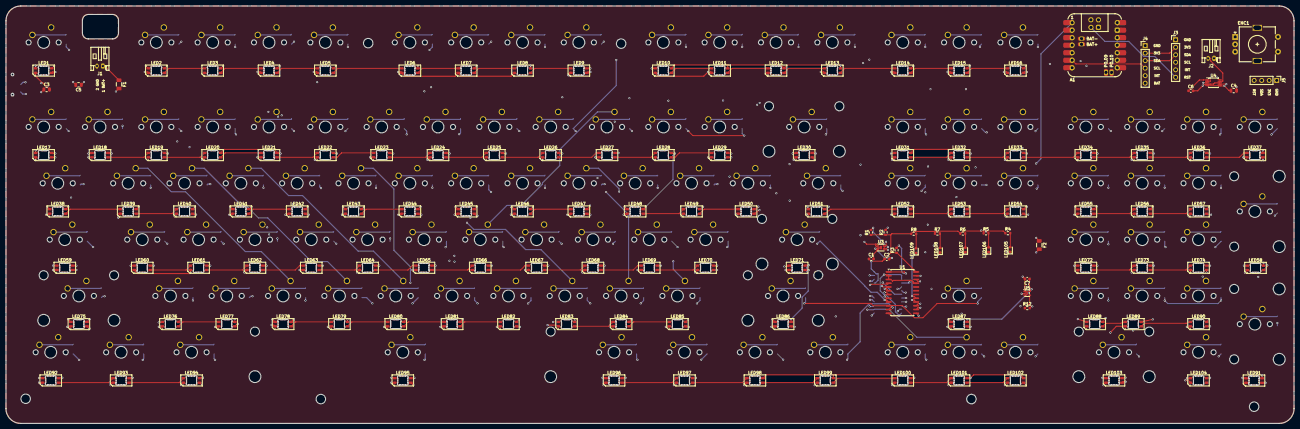
[picture p52: board Herox.kicad_pcb from above]

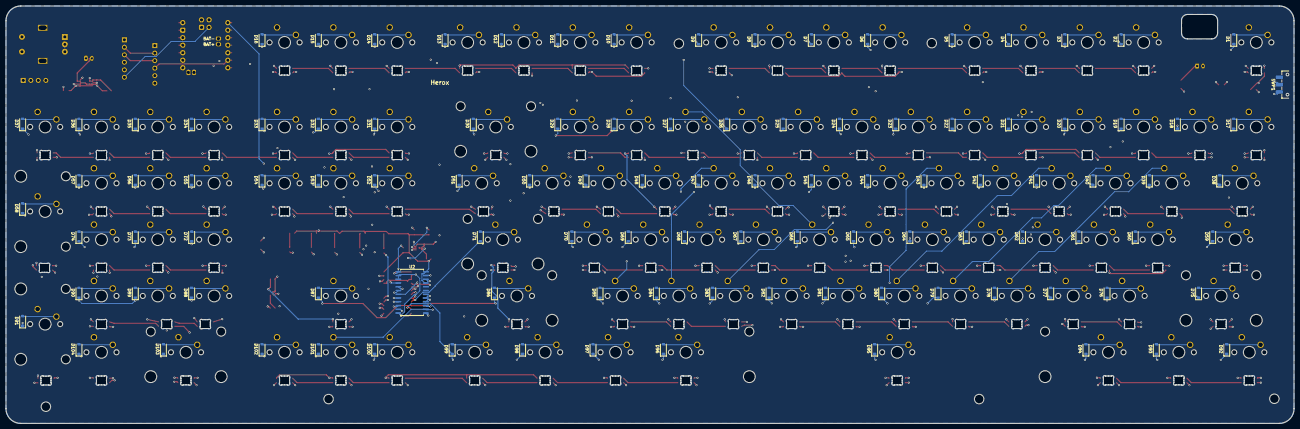
[picture p53: board Herox.kicad_pcb from below]

Board: 4 copper layers, 435.6 x 141.2 mm, 354 parts (106 on the bottom side), 260 nets.

Other parts of the board:
H2, H3, H5, H6, H7, H8: M3; MountingHole_3.2mm_M3
